Tuetuopay/pimouss-motherboard/3d/KUSBX-SL-CS1N14-B.step

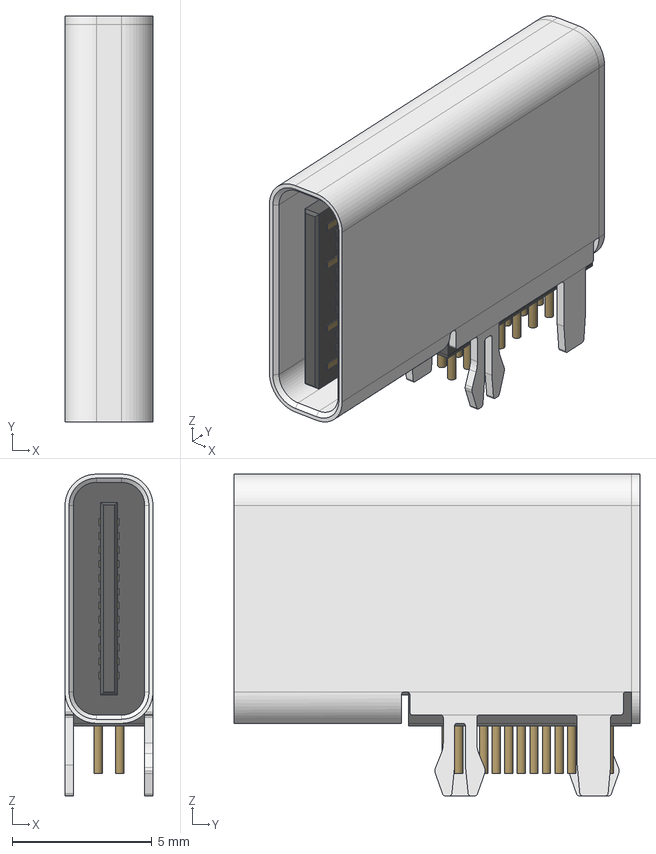
[picture p1: CAD file, 2019-11-23]
3d/KUSBX-SL-CS1N14-B.step
3.15 x 14.6 x 11.5 mm
Plastic
Pins
Contacts
