Tuetuopay/pimouss-motherboard/3d/pcie_4x.step

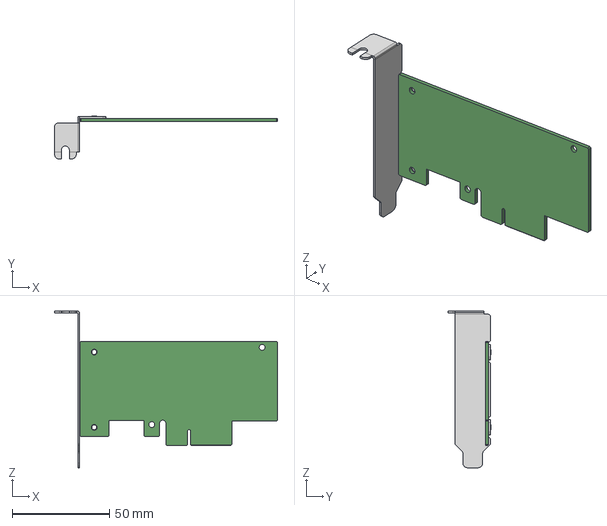
[picture p2: CAD file, 2019-05-04]
3d/pcie_4x.step
114.6 x 22.2 x 80.5 mm
