Tuetuopay/pimouss-motherboard/3d/barrel_jack.step

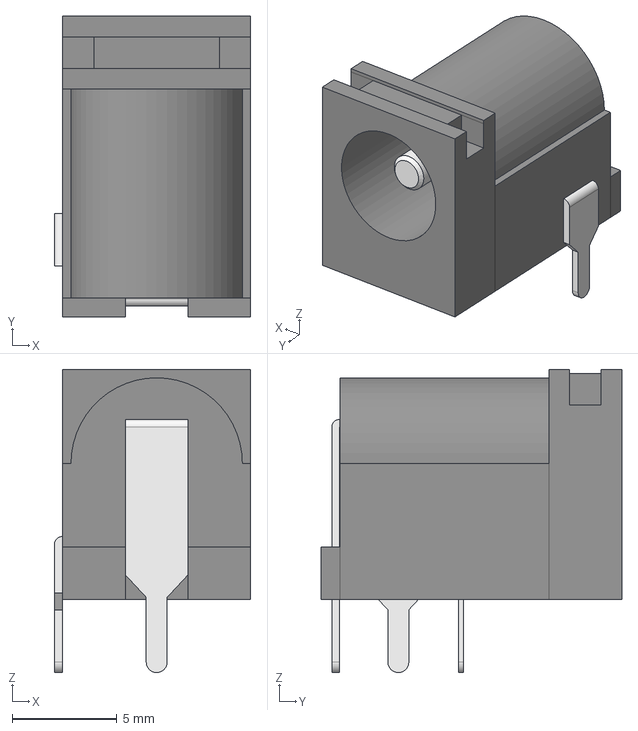
[picture p3: CAD file, 2019-05-04]
3d/barrel_jack.step
9.40 x 14.4 x 14.5 mm
