Tuetuopay/pimouss-motherboard/3d/mpcie_card.step

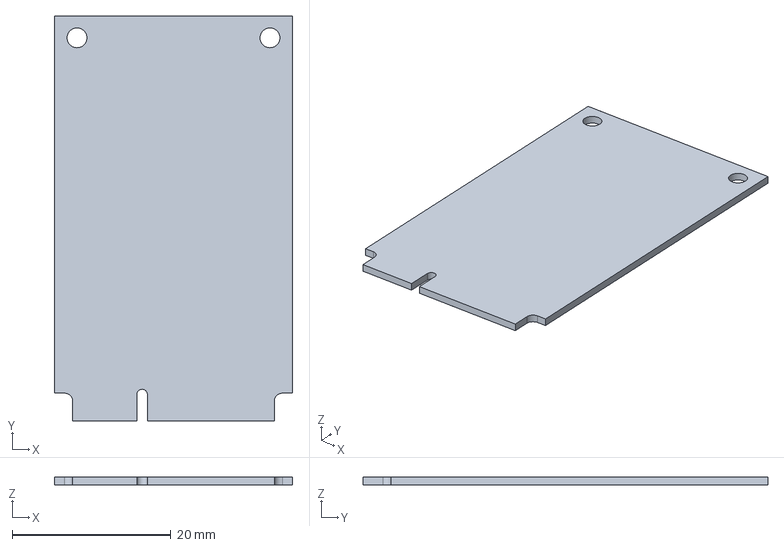
[picture p4: CAD file, 2019-05-04]
3d/mpcie_card.step
30.0 x 51.0 x 1.00 mm
