Tuetuopay/pimouss-motherboard/3d/pimouss.FCStd

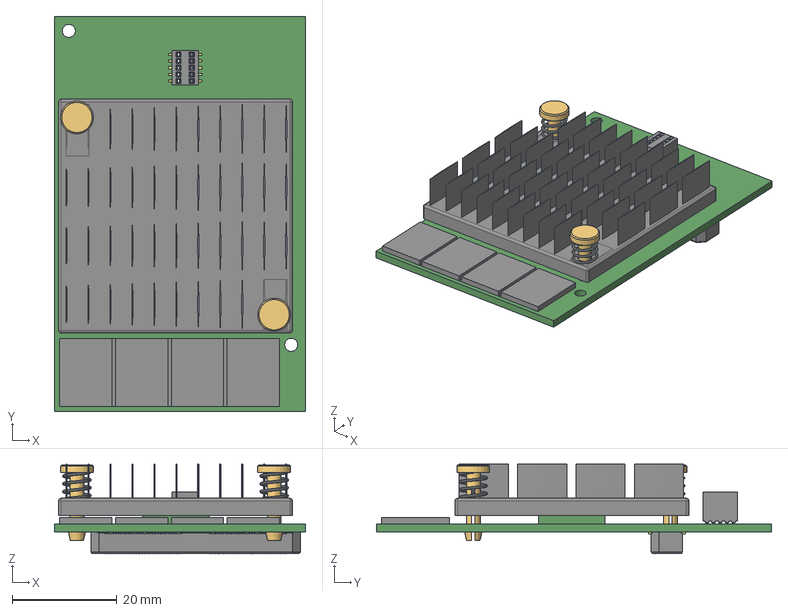
[picture p5: CAD file, 2019-04-30]
3d/pimouss.FCStd
48.0 x 75.5 x 17.1 mm
PCB
radiator
top left prong
bottom right prong
top left prong spring
bottom right prong spring
ram
RSM-105-02-D_socket
RSM-105-02-D_pins
QTH-060-01-F-D_socket
QTH-060-01-F-D_pins_r
QTH-060-01-F-D_pins_l
QTH-060-01-F-D_gnd_r
QTH-060-01-F-D_gnd_l
