Tuetuopay/pimouss-motherboard/3d/L_Vishay_IHHP-0806.step

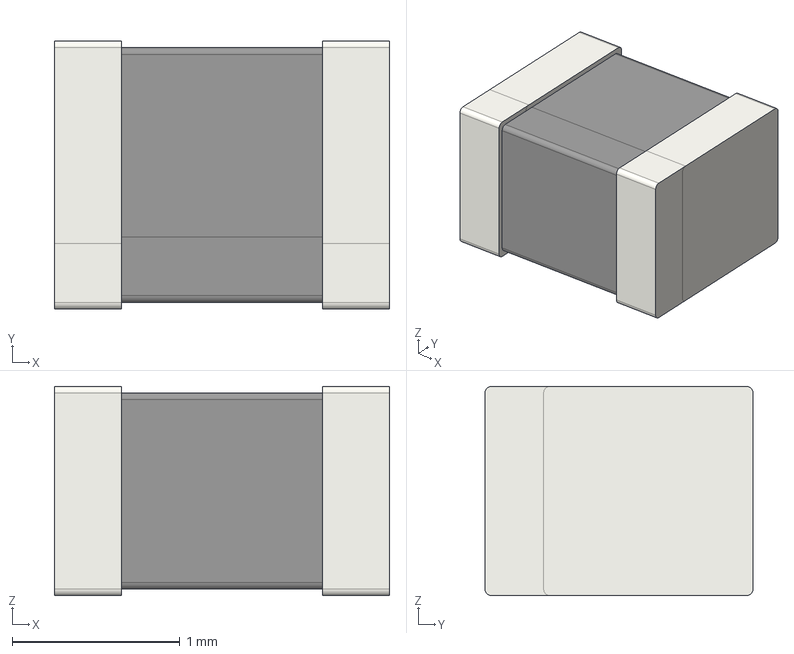
[picture p6: CAD file, 2019-04-01]
3d/L_Vishay_IHHP-0806.step
2.00 x 1.60 x 1.25 mm
