Tuetuopay/pimouss-motherboard/3d/USB-C-FEMALE.stp

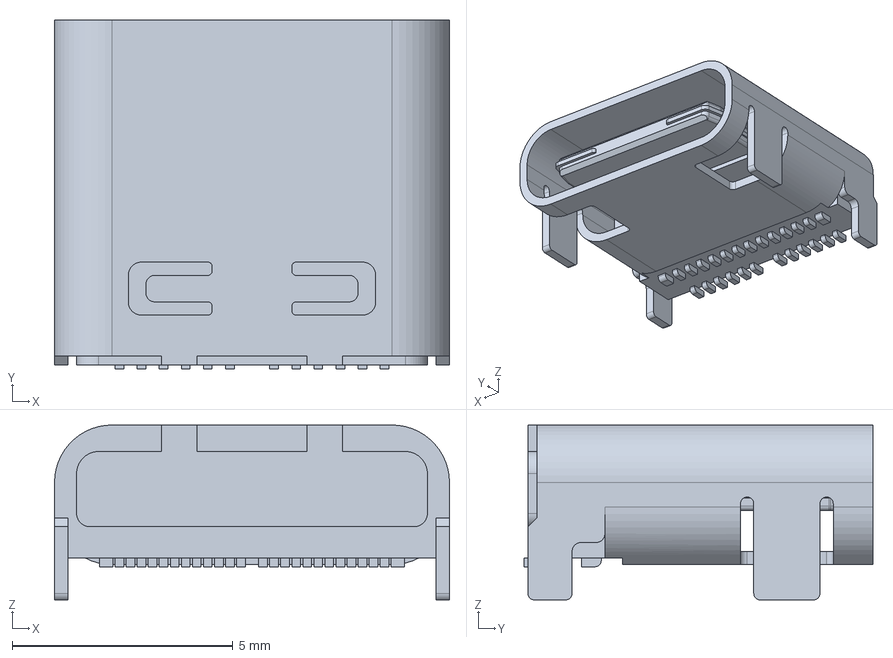
[picture p7: CAD file, 2019-03-24]
3d/USB-C-FEMALE.stp
8.94 x 7.90 x 3.96 mm
