Tuetuopay/pimouss-motherboard/3d/TMS-105-57-G-D.stp

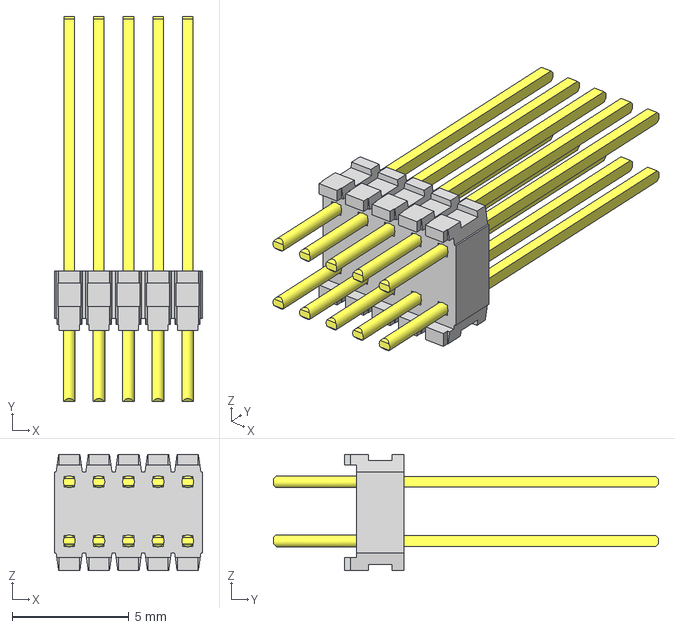
[picture p8: CAD file, 2019-03-24]
3d/TMS-105-57-G-D.stp
6.35 x 16.5 x 4.98 mm
_TMS-105-D_header
_T-1M6-05-57-D
