Tuetuopay/pimouss-motherboard/(list of files, cad)

Other CAD files:
3d/KUSBX-SL-CS1N14-B.FCStd
3d/L_Vishay_IHHP-0806.FCStd
3d/barrel_jack.FCStd
3d/mpcie_card.FCStd
3d/pcie_4x.FCStd
