Tuetuopay/pimouss-motherboard/pimouss-motherboard.kicad_pcb

## KiCad design pimouss-motherboard.kicad_pcb (2019-05-10)

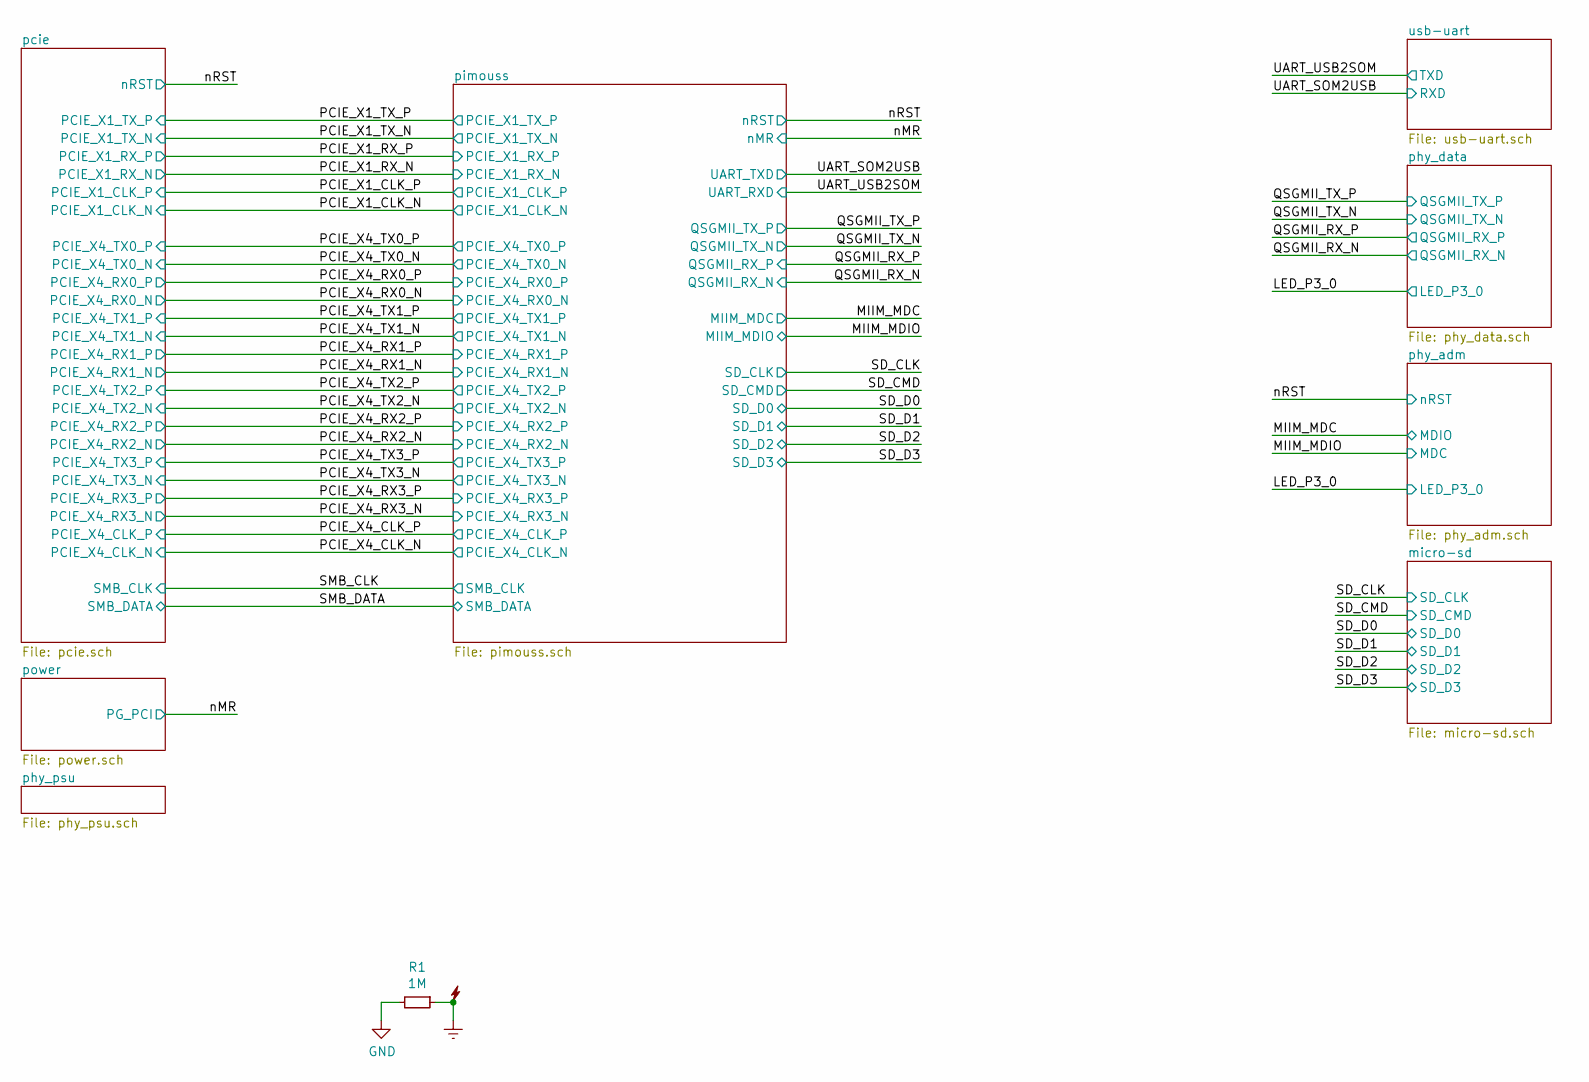
[picture p9: schematic pimouss-motherboard.sch, Pimouss Motherboard]

Parts:
R1: 1M; R_0603_1608Metric

Connections:
Earth: R1.1; also elsewhere on the board

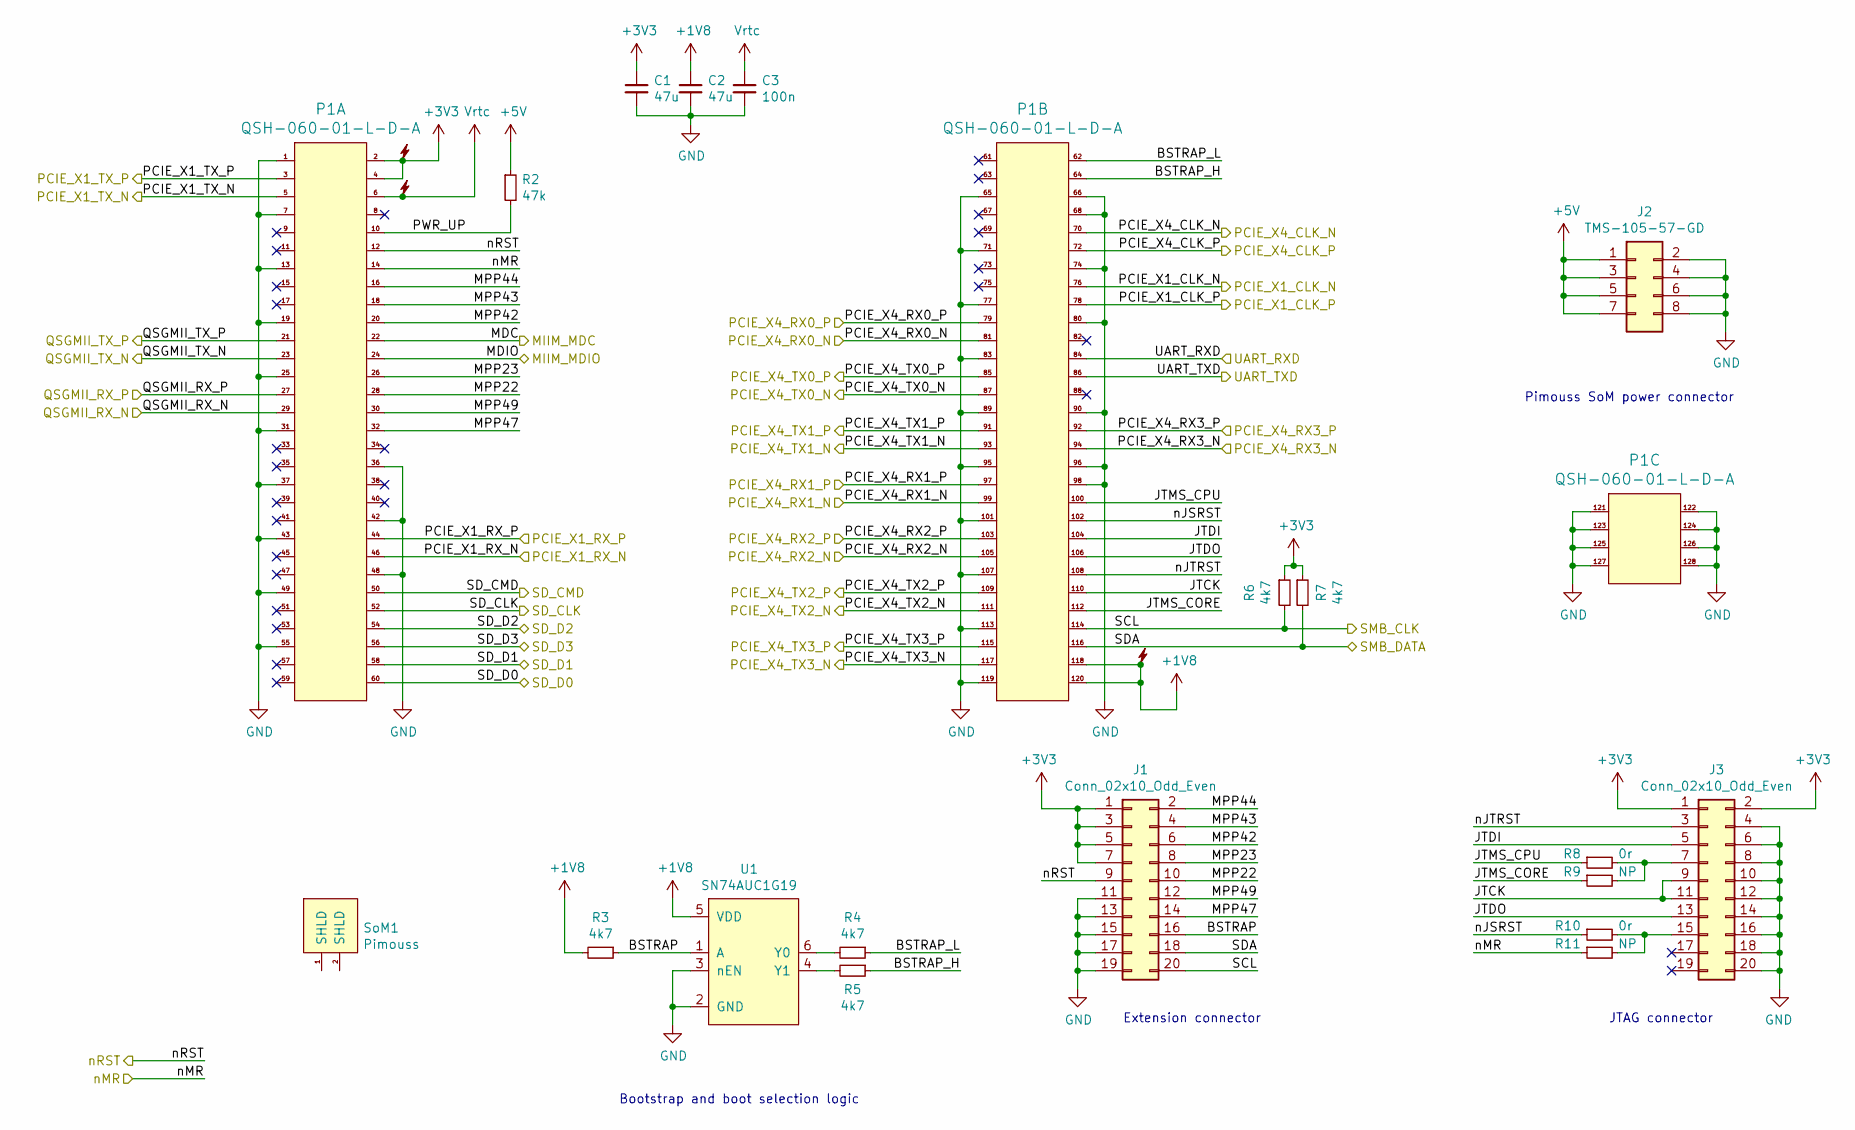
[picture p10: schematic pimouss.sch, The Pimouss itself]

Parts:
C1, C2: 47u; C_0805_2012Metric
C3: 100n; C_0603_1608Metric
J1, J3: Conn_02x10_Odd_Even; PinHeader_2x10_P2.54mm_Vertical
J2: TMS-105-57-GD; TMS-105-57-G-D
P1: QSH-060-01-L-D-A
R2: 47k; R_0603_1608Metric
R3, R4, R5, R6, R7: 4k7; R_0603_1608Metric
R8, R10: 0r; R_0603_1608Metric
R9, R11: NP; R_0603_1608Metric
SoM1: Pimouss
U1: SN74AUC1G19; SOT-23-6

Connections:
/MIIM_MDC: P1.22; also elsewhere on the board
/MIIM_MDIO: P1.24; also elsewhere on the board
/PCIE_X1_CLK_N: P1.76; also elsewhere on the board
/PCIE_X1_CLK_P: P1.78; also elsewhere on the board
/PCIE_X1_RX_N: P1.46; also elsewhere on the board
/PCIE_X1_RX_P: P1.44; also elsewhere on the board
/PCIE_X1_TX_N: P1.5; also elsewhere on the board
/PCIE_X1_TX_P: P1.3; also elsewhere on the board
/PCIE_X4_CLK_N: P1.70; also elsewhere on the board
/PCIE_X4_CLK_P: P1.72; also elsewhere on the board
/PCIE_X4_RX0_N: P1.81; also elsewhere on the board
/PCIE_X4_RX0_P: P1.79; also elsewhere on the board
/PCIE_X4_RX1_N: P1.99; also elsewhere on the board
/PCIE_X4_RX1_P: P1.97; also elsewhere on the board
/PCIE_X4_RX2_N: P1.105; also elsewhere on the board
/PCIE_X4_RX2_P: P1.103; also elsewhere on the board
/PCIE_X4_RX3_N: P1.94; also elsewhere on the board
/PCIE_X4_RX3_P: P1.92; also elsewhere on the board
/PCIE_X4_TX0_N: P1.87; also elsewhere on the board
/PCIE_X4_TX0_P: P1.85; also elsewhere on the board
/PCIE_X4_TX1_N: P1.93; also elsewhere on the board
/PCIE_X4_TX1_P: P1.91; also elsewhere on the board
/PCIE_X4_TX2_N: P1.111; also elsewhere on the board
/PCIE_X4_TX2_P: P1.109; also elsewhere on the board
/PCIE_X4_TX3_N: P1.117; also elsewhere on the board
/PCIE_X4_TX3_P: P1.115; also elsewhere on the board
/QSGMII_RX_N: P1.29; also elsewhere on the board
/QSGMII_RX_P: P1.27; also elsewhere on the board
/QSGMII_TX_N: P1.23; also elsewhere on the board
/QSGMII_TX_P: P1.21; also elsewhere on the board
/SD_CLK: P1.52; also elsewhere on the board
/SD_CMD: P1.50; also elsewhere on the board
/SD_D0: P1.60; also elsewhere on the board
/SD_D1: P1.58; also elsewhere on the board
/SD_D2: P1.54; also elsewhere on the board
/SD_D3: P1.56; also elsewhere on the board
/SMB_CLK: J1.20, P1.114, R6.2; also elsewhere on the board
/SMB_DATA: J1.18, P1.116, R7.2; also elsewhere on the board
/UART_SOM2USB: P1.86; also elsewhere on the board
/UART_USB2SOM: P1.84; also elsewhere on the board
/nMR: P1.14, R11.1; also elsewhere on the board
/nRST: J1.9, P1.12; also elsewhere on the board
/pimouss/BSTRAP: J1.16, R3.1, U1.1 (A)
/pimouss/BSTRAP_H: P1.64, R5.1
/pimouss/BSTRAP_L: P1.62, R4.1
/pimouss/JTCK: J3.9, J3.11, P1.110
/pimouss/JTDI: J3.5, P1.104
/pimouss/JTDO: J3.13, P1.106
/pimouss/JTMS_CORE: P1.112, R9.1
/pimouss/JTMS_CPU: P1.100, R8.1
/pimouss/MPP22: J1.10, P1.28
/pimouss/MPP23: J1.8, P1.26
/pimouss/MPP42: J1.6, P1.20
/pimouss/MPP43: J1.4, P1.18
/pimouss/MPP44: J1.2, P1.16
/pimouss/MPP47: J1.14, P1.32
/pimouss/MPP49: J1.12, P1.30
/pimouss/PWR_UP: P1.10, R2.2
/pimouss/nJSRST: P1.102, R10.1
/pimouss/nJTRST: J3.3, P1.108
unnamed: J3.7, R8.2, R9.2
unnamed: J3.15, R10.2, R11.2
unnamed: R4.2, U1.6 (Y0)
unnamed: R5.2, U1.4 (Y1)

Notes on the sheet:
Pimouss SoM power connector
Bootstrap and boot selection logic
JTAG connector
Extension connector

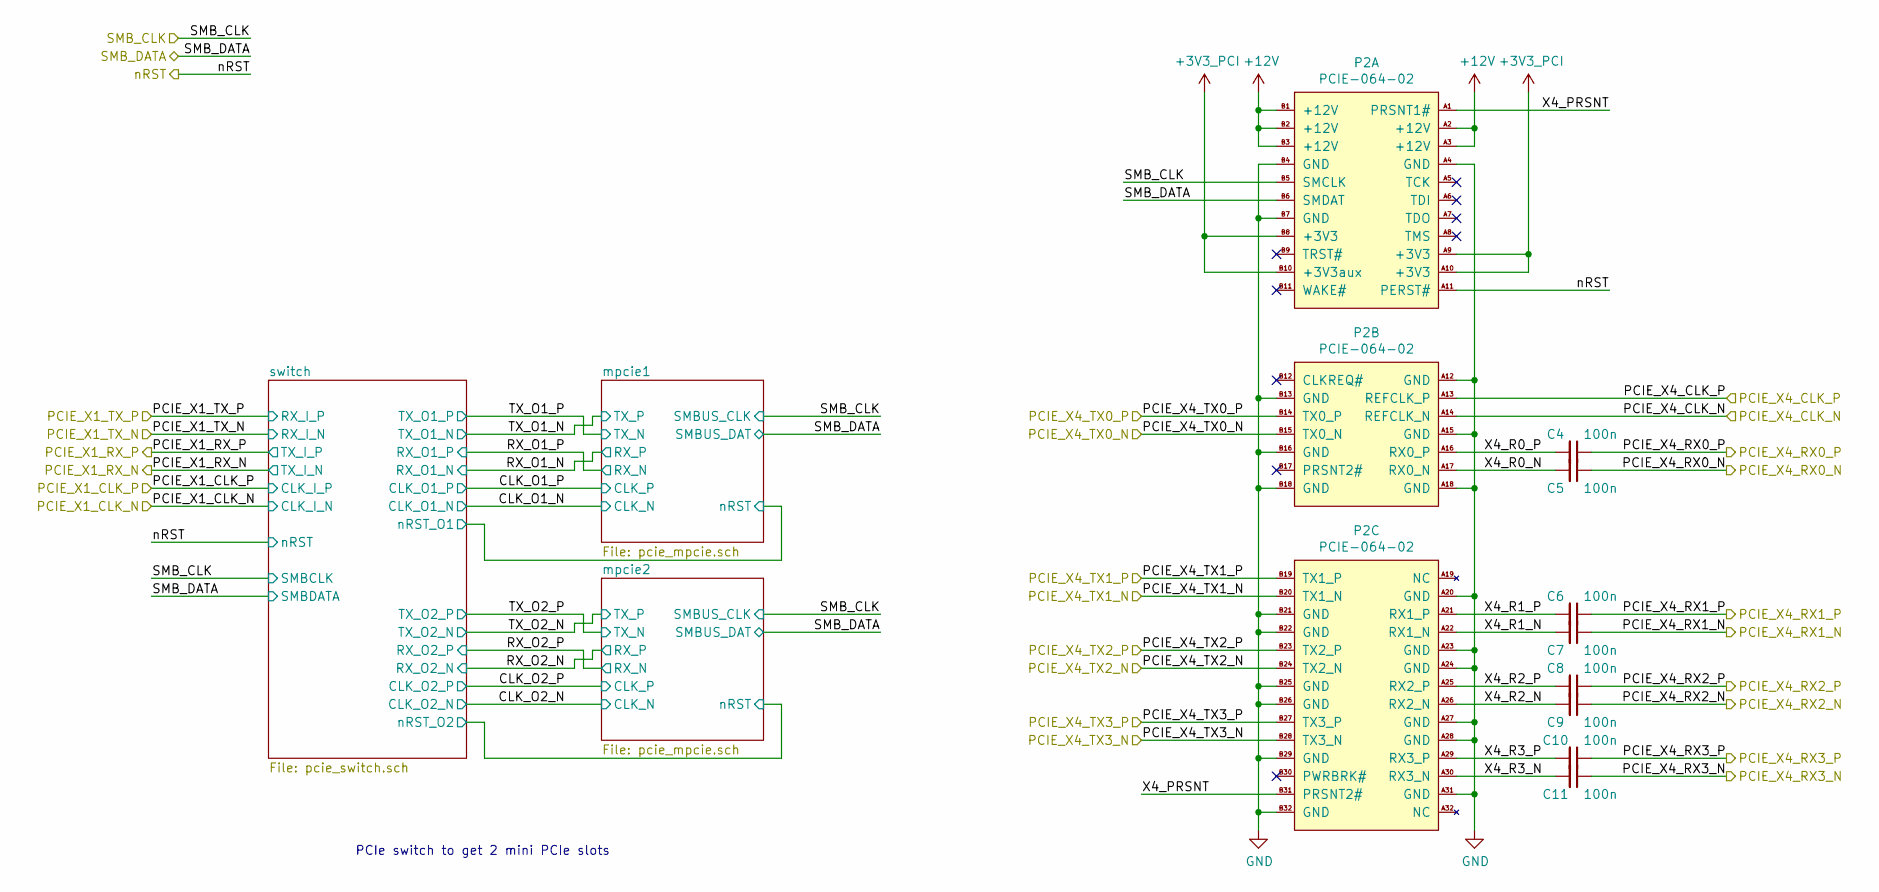
[picture p11: schematic pcie.sch, PCI Express connectors]

Parts:
C4, C5, C6, C7, C8, C9, C10, C11: 100n; C_0402_1005Metric
P2: PCIE-064-02; SAMTEC_PCIE-064-02-F-D-TH

Connections:
/PCIE_X4_CLK_N: P2.A14 (REFCLK_N); also elsewhere on the board
/PCIE_X4_CLK_P: P2.A13 (REFCLK_P); also elsewhere on the board
/PCIE_X4_RX0_N: C5.1; also elsewhere on the board
/PCIE_X4_RX0_P: C4.1; also elsewhere on the board
/PCIE_X4_RX1_N: C7.1; also elsewhere on the board
/PCIE_X4_RX1_P: C6.1; also elsewhere on the board
/PCIE_X4_RX2_N: C9.1; also elsewhere on the board
/PCIE_X4_RX2_P: C8.1; also elsewhere on the board
/PCIE_X4_RX3_N: C11.1; also elsewhere on the board
/PCIE_X4_RX3_P: C10.1; also elsewhere on the board
/PCIE_X4_TX0_N: P2.B15 (TX0_N); also elsewhere on the board
/PCIE_X4_TX0_P: P2.B14 (TX0_P); also elsewhere on the board
/PCIE_X4_TX1_N: P2.B20 (TX1_N); also elsewhere on the board
/PCIE_X4_TX1_P: P2.B19 (TX1_P); also elsewhere on the board
/PCIE_X4_TX2_N: P2.B24 (TX2_N); also elsewhere on the board
/PCIE_X4_TX2_P: P2.B23 (TX2_P); also elsewhere on the board
/PCIE_X4_TX3_N: P2.B28 (TX3_N); also elsewhere on the board
/PCIE_X4_TX3_P: P2.B27 (TX3_P); also elsewhere on the board
/SMB_CLK: P2.B5 (SMCLK); also elsewhere on the board
/SMB_DATA: P2.B6 (SMDAT); also elsewhere on the board
/nRST: P2.A11 (PERST#); also elsewhere on the board
/pcie/X4_PRSNT: P2.A1 (PRSNT1#), P2.B31 (PRSNT2#)
/pcie/X4_R0_N: C5.2, P2.A17 (RX0_N)
/pcie/X4_R0_P: C4.2, P2.A16 (RX0_P)
/pcie/X4_R1_N: C7.2, P2.A22 (RX1_N)
/pcie/X4_R1_P: C6.2, P2.A21 (RX1_P)
/pcie/X4_R2_N: C9.2, P2.A26 (RX2_N)
/pcie/X4_R2_P: C8.2, P2.A25 (RX2_P)
/pcie/X4_R3_N: C11.2, P2.A30 (RX3_N)
/pcie/X4_R3_P: C10.2, P2.A29 (RX3_P)

Notes on the sheet:
PCIe switch to get 2 mini PCIe slots

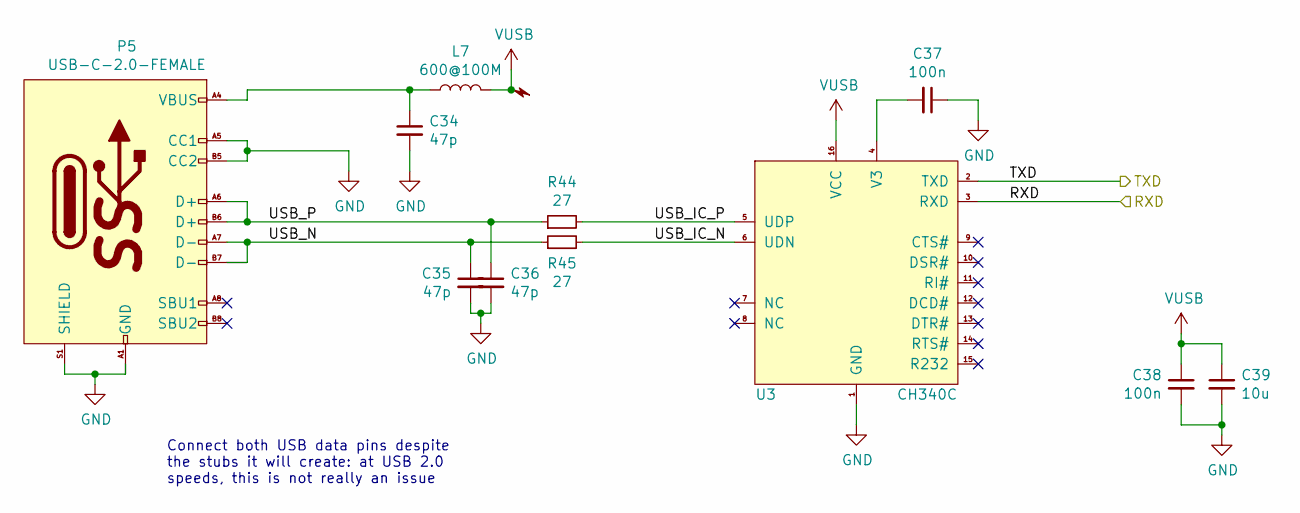
[picture p12: schematic usb-uart.sch, USB to UART conversion]

Parts:
C34, C35, C36: 47p; C_0603_1608Metric
C37, C38: 100n; C_0603_1608Metric
C39: 10u; C_0603_1608Metric
L7: 600@100M; L_0603_1608Metric
P5: USB-C-2.0-FEMALE; USB-C-FEMALE
R44, R45: 27; R_0603_1608Metric
U3: CH340C; SSOP-20_5.3x7.2mm_P0.65mm

Connections:
/UART_SOM2USB: U3.3 (RXD); also elsewhere on the board
/UART_USB2SOM: U3.2 (TXD); also elsewhere on the board
/usb-uart/USB_IC_N: R45.2, U3.6 (UDN)
/usb-uart/USB_IC_P: R44.2, U3.5 (UDP)
/usb-uart/USB_N: C35.1, P5.A7 (D-), P5.B7 (D-), R45.1
/usb-uart/USB_P: C36.1, P5.A6 (D+), P5.B6 (D+), R44.1
unnamed: C34.1, L7.1, P5.A4 (VBUS), P5.A9 (VBUS), P5.B4 (VBUS), P5.B9 (VBUS)
unnamed: C37.2, U3.4 (V3)
VUSB: C38.1, C39.1, L7.2, U3.16 (VCC)

Notes on the sheet:
Connect both USB data pins despite the stubs it will create: at USB 2.0 speeds, this is not really an issue

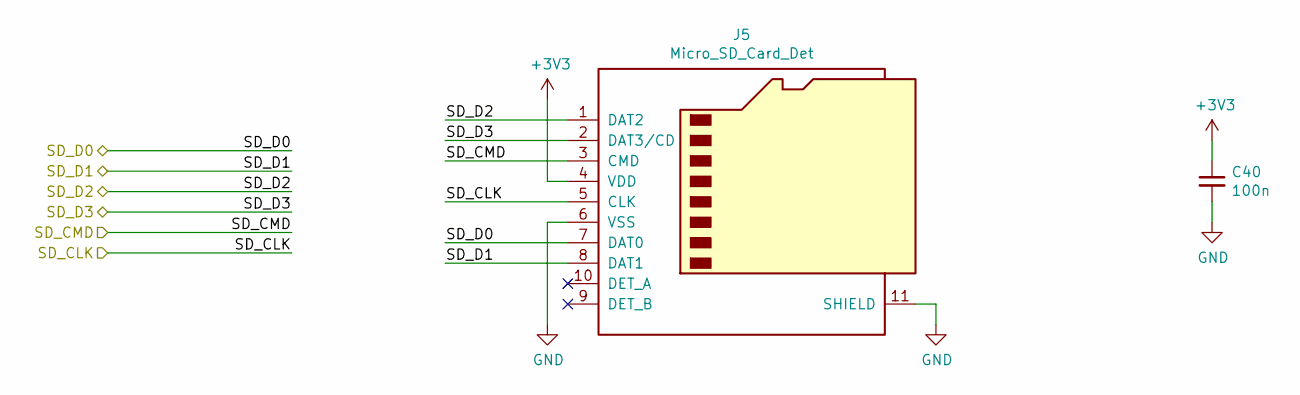
[picture p13: schematic micro-sd.sch, µSD Card storage]

Parts:
C40: 100n; C_0603_1608Metric
J5: Micro_SD_Card_Det; microSD_HC_Hirose_DM3D-SF

Connections:
/SD_CLK: J5.5 (CLK); also elsewhere on the board
/SD_CMD: J5.3 (CMD); also elsewhere on the board
/SD_D0: J5.7 (DAT0); also elsewhere on the board
/SD_D1: J5.8 (DAT1); also elsewhere on the board
/SD_D2: J5.1 (DAT2); also elsewhere on the board
/SD_D3: J5.2 (DAT3/CD); also elsewhere on the board

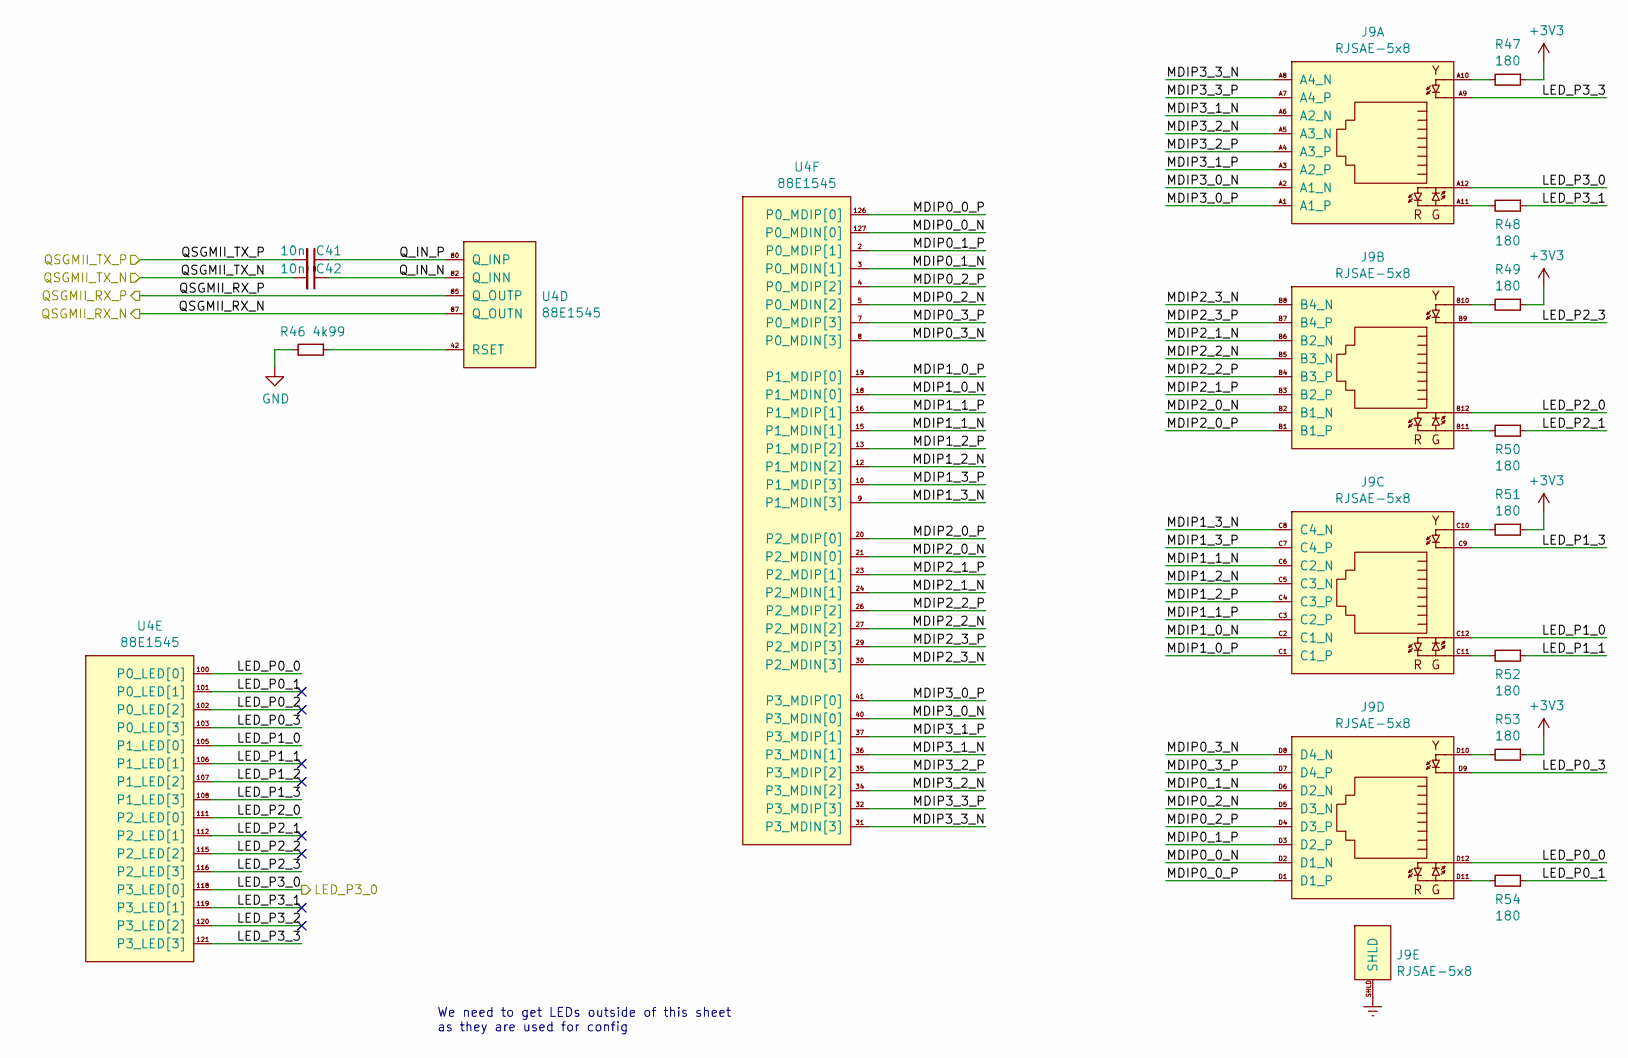
[picture p14: schematic phy_data.sch, PHY data plane]

Parts:
C41, C42: 10n; C_0402_1005Metric
J9: RJSAE-5x8
R46: 4k99; R_0603_1608Metric
R47, R48, R49, R50, R51, R52, R53, R54: 180; R_0603_1608Metric
U4: 88E1545; LQFP-128-1EP_14x20mm_P0.5mm_EP3.93x6.42mm

Connections:
/LED_P3_0: J9.A12, U4.118 (P3_LED[0]); also elsewhere on the board
/QSGMII_RX_N: U4.87 (Q_OUTN); also elsewhere on the board
/QSGMII_RX_P: U4.85 (Q_OUTP); also elsewhere on the board
/QSGMII_TX_N: C42.2; also elsewhere on the board
/QSGMII_TX_P: C41.2; also elsewhere on the board
/phy_data/LED_P0_0: J9.D12, U4.100 (P0_LED[0])
/phy_data/LED_P0_1: R54.1, U4.101 (P0_LED[1])
/phy_data/LED_P0_2: U4.102 (P0_LED[2])
/phy_data/LED_P0_3: J9.D9, U4.103 (P0_LED[3])
/phy_data/LED_P1_0: J9.C12, U4.105 (P1_LED[0])
/phy_data/LED_P1_1: R52.1, U4.106 (P1_LED[1])
/phy_data/LED_P1_2: U4.107 (P1_LED[2])
/phy_data/LED_P1_3: J9.C9, U4.108 (P1_LED[3])
/phy_data/LED_P2_0: J9.B12, U4.111 (P2_LED[0])
/phy_data/LED_P2_1: R50.1, U4.112 (P2_LED[1])
/phy_data/LED_P2_2: U4.115 (P2_LED[2])
/phy_data/LED_P2_3: J9.B9, U4.116 (P2_LED[3])
/phy_data/LED_P3_1: R48.1, U4.119 (P3_LED[1])
/phy_data/LED_P3_2: U4.120 (P3_LED[2])
/phy_data/LED_P3_3: J9.A9, U4.121 (P3_LED[3])
/phy_data/MDIP0_0_N: J9.D2 (D1_N), U4.127 (P0_MDIN[0])
/phy_data/MDIP0_0_P: J9.D1 (D1_P), U4.126 (P0_MDIP[0])
/phy_data/MDIP0_1_N: J9.D6 (D2_N), U4.3 (P0_MDIN[1])
/phy_data/MDIP0_1_P: J9.D3 (D2_P), U4.2 (P0_MDIP[1])
/phy_data/MDIP0_2_N: J9.D5 (D3_N), U4.5 (P0_MDIN[2])
/phy_data/MDIP0_2_P: J9.D4 (D3_P), U4.4 (P0_MDIP[2])
/phy_data/MDIP0_3_N: J9.D8 (D4_N), U4.8 (P0_MDIN[3])
/phy_data/MDIP0_3_P: J9.D7 (D4_P), U4.7 (P0_MDIP[3])
/phy_data/MDIP1_0_N: J9.C2 (C1_N), U4.18 (P1_MDIN[0])
/phy_data/MDIP1_0_P: J9.C1 (C1_P), U4.19 (P1_MDIP[0])
/phy_data/MDIP1_1_N: J9.C6 (C2_N), U4.15 (P1_MDIN[1])
/phy_data/MDIP1_1_P: J9.C3 (C2_P), U4.16 (P1_MDIP[1])
/phy_data/MDIP1_2_N: J9.C5 (C3_N), U4.12 (P1_MDIN[2])
/phy_data/MDIP1_2_P: J9.C4 (C3_P), U4.13 (P1_MDIP[2])
/phy_data/MDIP1_3_N: J9.C8 (C4_N), U4.9 (P1_MDIN[3])
/phy_data/MDIP1_3_P: J9.C7 (C4_P), U4.10 (P1_MDIP[3])
/phy_data/MDIP2_0_N: J9.B2 (B1_N), U4.21 (P2_MDIN[0])
/phy_data/MDIP2_0_P: J9.B1 (B1_P), U4.20 (P2_MDIP[0])
/phy_data/MDIP2_1_N: J9.B6 (B2_N), U4.24 (P2_MDIN[1])
/phy_data/MDIP2_1_P: J9.B3 (B2_P), U4.23 (P2_MDIP[1])
/phy_data/MDIP2_2_N: J9.B5 (B3_N), U4.27 (P2_MDIN[2])
/phy_data/MDIP2_2_P: J9.B4 (B3_P), U4.26 (P2_MDIP[2])
/phy_data/MDIP2_3_N: J9.B8 (B4_N), U4.30 (P2_MDIN[3])
/phy_data/MDIP2_3_P: J9.B7 (B4_P), U4.29 (P2_MDIP[3])
/phy_data/MDIP3_0_N: J9.A2 (A1_N), U4.40 (P3_MDIN[0])
/phy_data/MDIP3_0_P: J9.A1 (A1_P), U4.41 (P3_MDIP[0])
/phy_data/MDIP3_1_N: J9.A6 (A2_N), U4.36 (P3_MDIN[1])
/phy_data/MDIP3_1_P: J9.A3 (A2_P), U4.37 (P3_MDIP[1])
/phy_data/MDIP3_2_N: J9.A5 (A3_N), U4.34 (P3_MDIN[2])
/phy_data/MDIP3_2_P: J9.A4 (A3_P), U4.35 (P3_MDIP[2])
/phy_data/MDIP3_3_N: J9.A8 (A4_N), U4.31 (P3_MDIN[3])
/phy_data/MDIP3_3_P: J9.A7 (A4_P), U4.32 (P3_MDIP[3])
/phy_data/Q_IN_N: C42.1, U4.82 (Q_INN)
/phy_data/Q_IN_P: C41.1, U4.80 (Q_INP)
Earth: J9.SHLD; also elsewhere on the board
unnamed: J9.A10, R47.2
unnamed: J9.A11, R48.2
unnamed: J9.B10, R49.2
unnamed: J9.B11, R50.2
unnamed: J9.C10, R51.2
unnamed: J9.C11, R52.2
unnamed: J9.D10, R53.2
unnamed: J9.D11, R54.2
unnamed: R46.1, U4.42 (RSET)

Notes on the sheet:
We need to get LEDs outside of this sheet as they are used for config

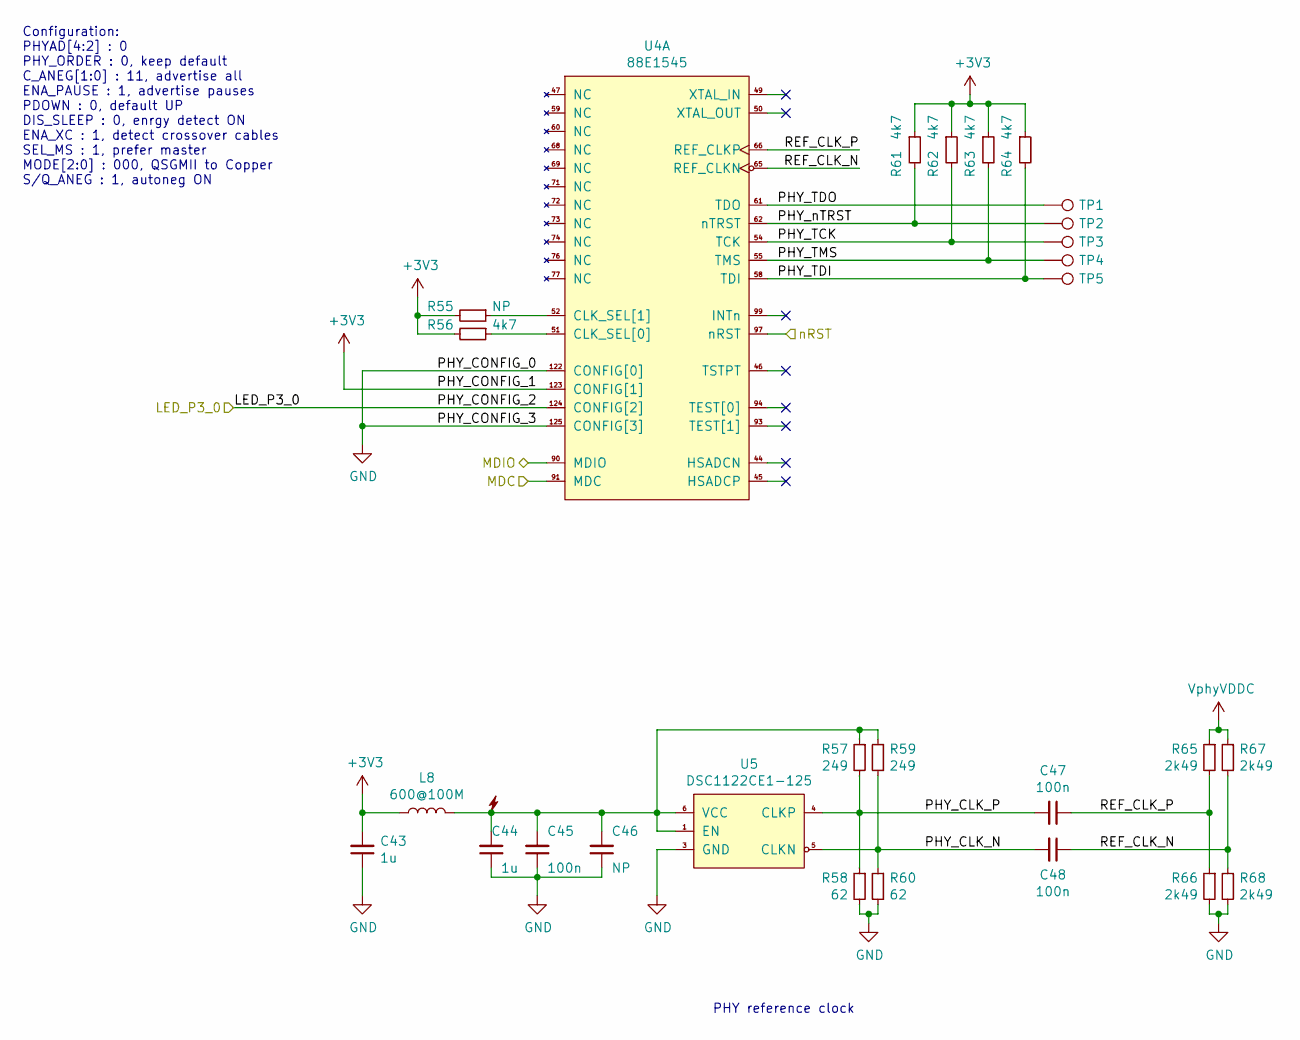
[picture p15: schematic phy_adm.sch, PHY control plane]

Parts:
C43, C44: 1u; C_0603_1608Metric
C45: 100n; C_0603_1608Metric
C46: NP; C_0603_1608Metric
C47, C48: 100n; C_0402_1005Metric
L8: 600@100M; L_0603_1608Metric
R55: NP; R_0603_1608Metric
R56, R61, R62, R63, R64: 4k7; R_0603_1608Metric
R57, R59: 249; R_0402_1005Metric
R58, R60: 62; R_0402_1005Metric
R65, R66, R67, R68: 2k49; R_0402_1005Metric
TP1, TP2, TP3, TP4, TP5: TestPoint; TestPoint_Pad_D1.0mm
U4: 88E1545; LQFP-128-1EP_14x20mm_P0.5mm_EP3.93x6.42mm
U5: DSC1122CE1-125; DFN-6_2.5x2mm_P0.825mm

Connections:
/LED_P3_0: U4.124 (CONFIG[2]); also elsewhere on the board
/MIIM_MDC: U4.90 (MDIO); also elsewhere on the board
/MIIM_MDIO: U4.91 (MDC); also elsewhere on the board
/nRST: U4.97 (nRST); also elsewhere on the board
/phy_adm/PHY_CLK_N: C48.2, R59.2, R60.1, U5.5 (CLKN)
/phy_adm/PHY_CLK_P: C47.2, R57.2, R58.1, U5.4 (CLKP)
/phy_adm/PHY_TCK: R62.2, TP3.1, U4.54 (TCK)
/phy_adm/PHY_TDI: R64.2, TP5.1, U4.58 (TDI)
/phy_adm/PHY_TDO: TP1.1, U4.61 (TDO)
/phy_adm/PHY_TMS: R63.2, TP4.1, U4.55 (TMS)
/phy_adm/PHY_nTRST: R61.2, TP2.1, U4.62 (nTRST)
/phy_adm/REF_CLK_N: C48.1, R67.2, R68.1, U4.65 (REF_CLKN)
/phy_adm/REF_CLK_P: C47.1, R65.2, R66.1, U4.66 (REF_CLKP)
unnamed: C44.2, C45.2, C46.2, L8.2, R57.1, R59.1, U5.1 (EN), U5.6 (VCC)
unnamed: R55.1, U4.52 (CLK_SEL[1])
unnamed: R56.1, U4.51 (CLK_SEL[0])

Notes on the sheet:
Configuration: PHYAD[4:2] : 0 PHY_ORDER : 0, keep default C_ANEG[1:0] : 11, advertise all ENA_PAUSE : 1, advertise pauses PDOWN : 0, default UP DIS_SLEEP : 0, enrgy detect ON ENA_XC : 1, detect crossover cables SEL_MS : 1, prefer master MODE[2:0] : 000, QSGMII to Copper S/Q_ANEG : 1, autoneg ON
PHY reference clock

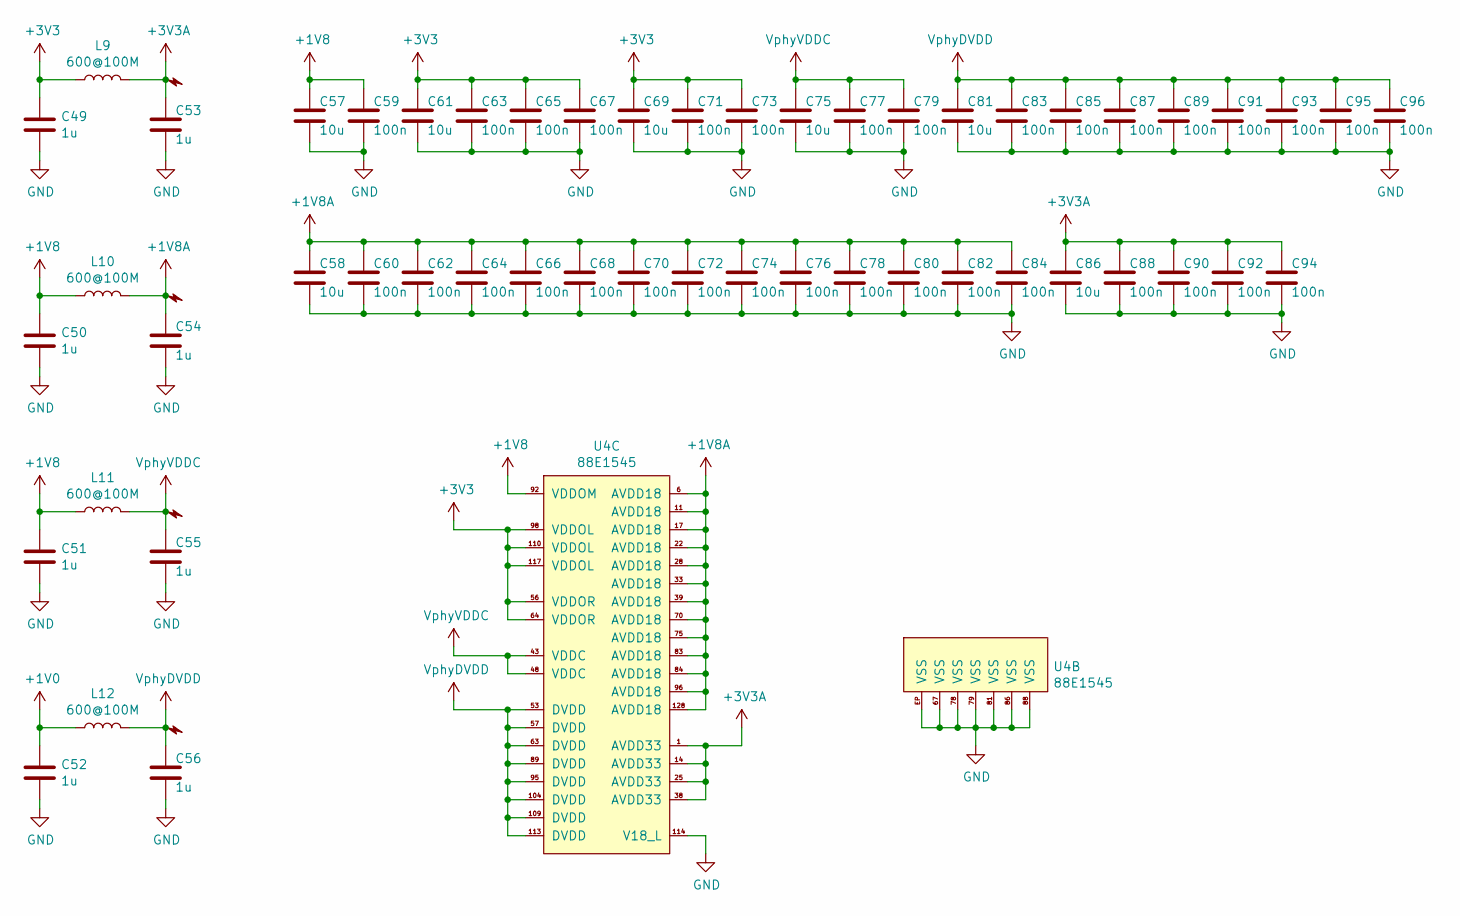
[picture p16: schematic phy_psu.sch, PHY power supply]

Parts:
C49, C50, C51, C52, C53, C54, C55, C56: 1u; C_0603_1608Metric
C57, C58, C61, C69, C75, C81, C86: 10u; C_0603_1608Metric
C59, C60, C62, C63, C64, C65, C66, C67, C68, C70, C71, C72, C73, C74, C76, C77, C78, C79, C80, C82, C83, C84, C85, C87, C88, C89, C90, C91, C92, C93, C94, C95, C96: 100n; C_0603_1608Metric
L9, L10, L11, L12: 600@100M; L_0603_1608Metric
U4: 88E1545; LQFP-128-1EP_14x20mm_P0.5mm_EP3.93x6.42mm

Connections:
+1V0: C52.1, L12.1; also elsewhere on the board

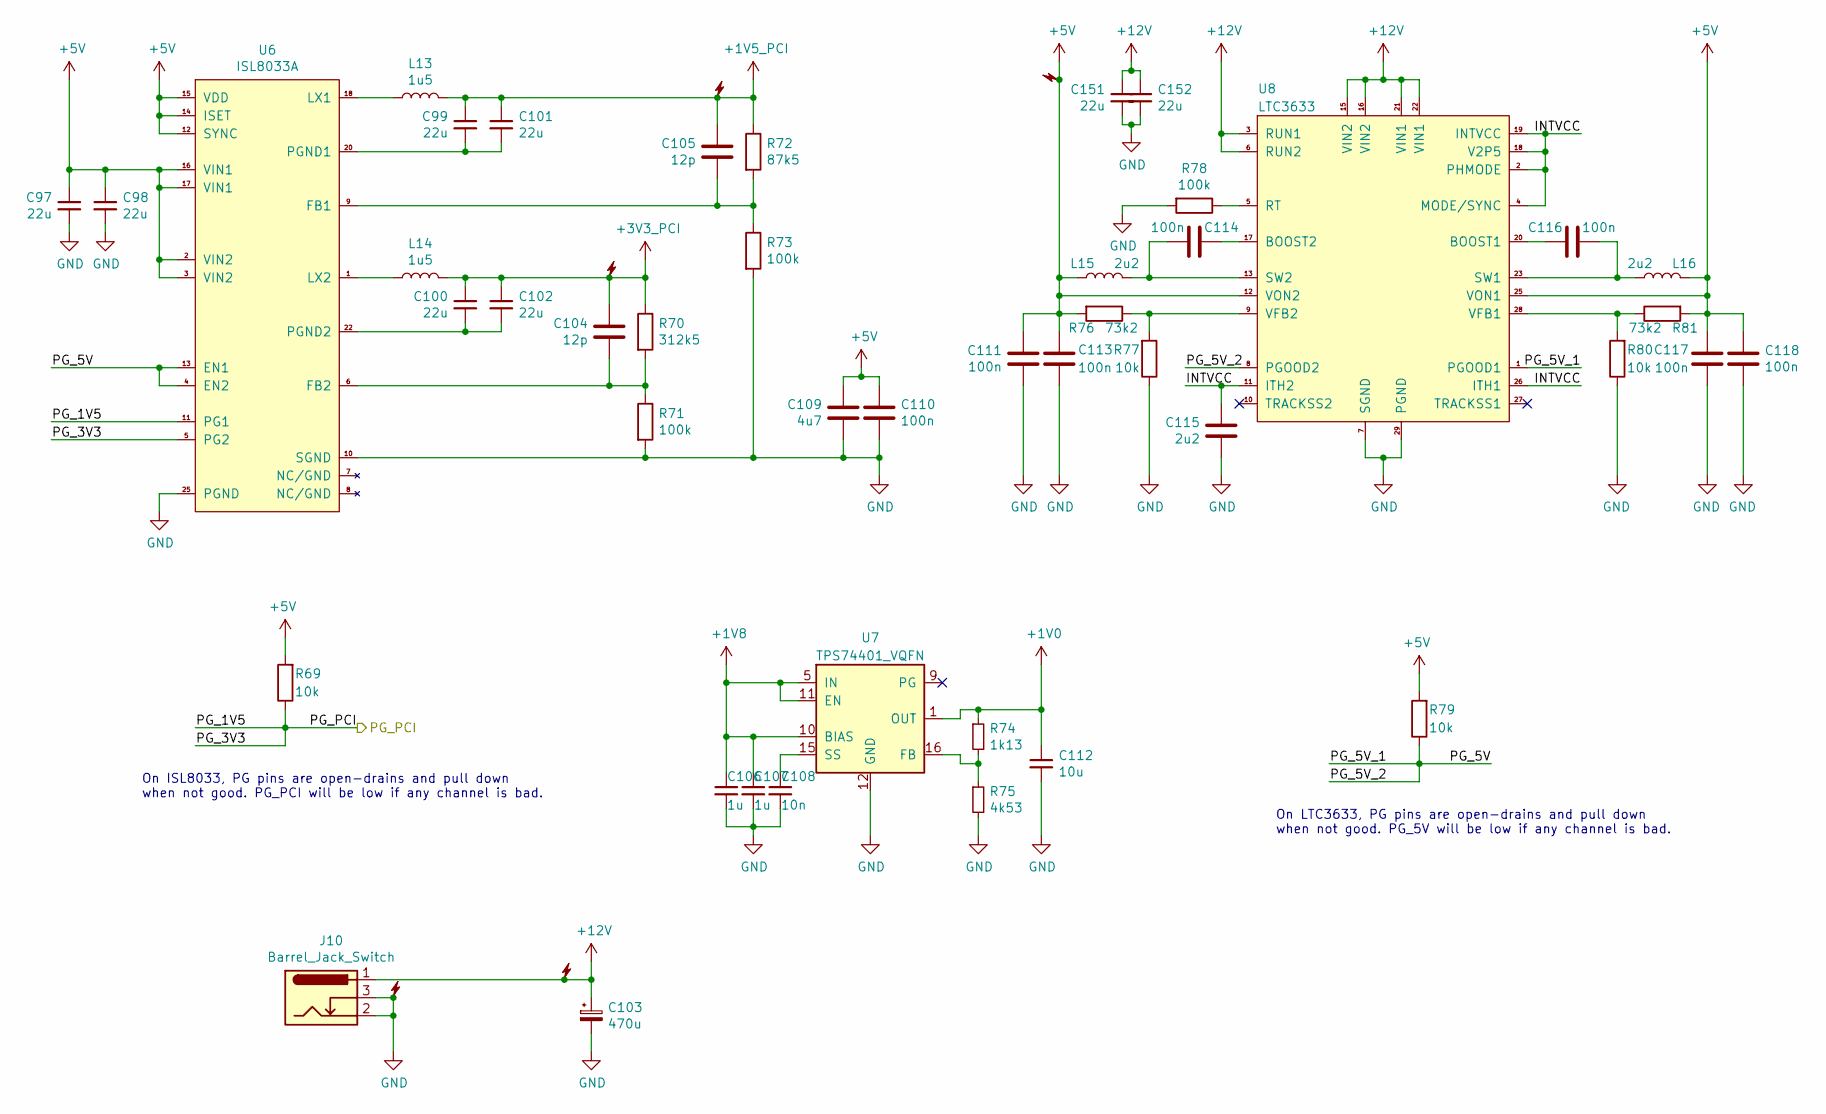
[picture p17: schematic power.sch, Main board power supplies]

Parts:
C97, C98, C99, C100, C101, C102, C151, C152: 22u; C_0805_2012Metric
C103: 470u; CP_Elec_10x10
C104, C105: 12p; C_0603_1608Metric
C106, C107: 1u; C_0603_1608Metric
C108: 10n; C_0603_1608Metric
C109: 4u7; C_0603_1608Metric
C110, C111, C113, C114, C116, C117, C118: 100n; C_0603_1608Metric
C112: 10u; C_0603_1608Metric
C115: 2u2; C_0603_1608Metric
J10: Barrel_Jack_Switch; BarrelJack_Horizontal
L13, L14: 1u5; L_Vishay_IHHP-0806
L15, L16: 2u2; L_Vishay_IHHP-0806
R69, R77, R79, R80: 10k; R_0603_1608Metric
R70: 312k5; R_0603_1608Metric
R71, R73, R78: 100k; R_0603_1608Metric
R72: 87k5; R_0603_1608Metric
R74: 1k13; R_0603_1608Metric
R75: 4k53; R_0603_1608Metric
R76, R81: 73k2; R_0603_1608Metric
U6: ISL8033A; QFN-24-1EP_4x4mm_P0.5mm_EP2.6x2.6mm
U7: TPS74401_VQFN; Texas_S-PVQFN-N20_EP3.15x3.15mm_ThermalVias
U8: LTC3633; QFN-28-1EP_4x5mm_P0.5mm_EP2.65x3.65mm_ThermalVias

Connections:
+1V0: C112.1, R74.1, U7.1 (OUT), U7.18 (OUT), U7.19 (OUT), U7.20 (OUT); also elsewhere on the board
/nMR: R69.1, U6.5 (PG2), U6.11 (PG1); also elsewhere on the board
/power/INTVCC: C115.2, U8.2 (PHMODE), U8.4 (MODE/SYNC), U8.11 (ITH2), U8.18 (V2P5), U8.19 (INTVCC), U8.26 (ITH1)
/power/PG_5V: R79.1, U6.4 (EN2), U6.13 (EN1), U8.1 (PGOOD1), U8.8 (PGOOD2)
unnamed: C100.2, C102.2, U6.22 (PGND2), U6.23 (PGND2)
unnamed: C99.2, C101.2, U6.20 (PGND1), U6.21 (PGND1)
unnamed: C104.2, R70.2, R71.1, U6.6 (FB2)
unnamed: C105.2, R72.2, R73.1, U6.9 (FB1)
unnamed: C108.1, U7.15 (SS)
unnamed: C114.1, U8.17 (BOOST2)
unnamed: C114.2, L15.2, U8.13 (SW2), U8.14 (SW2)
unnamed: C116.1, U8.20 (BOOST1)
unnamed: C116.2, L16.2, U8.23 (SW1), U8.24 (SW1)
unnamed: L13.1, U6.18 (LX1), U6.19 (LX1)
unnamed: L14.1, U6.1 (LX2), U6.24 (LX2)
unnamed: R74.2, R75.1, U7.16 (FB)
unnamed: R76.1, R77.2, U8.9 (VFB2)
unnamed: R78.1, U8.5 (RT)
unnamed: R80.2, R81.1, U8.28 (VFB1)

Notes on the sheet:
On LTC3633, PG pins are open-drains and pull down when not good. PG_5V will be low if any channel is bad.
On ISL8033, PG pins are open-drains and pull down when not good. PG_PCI will be low if any channel is bad.
