Tuetuopay/pimouss-motherboard/pimouss-motherboard.kicad_pcb

## KiCad design pimouss-motherboard.kicad_pcb (continued)

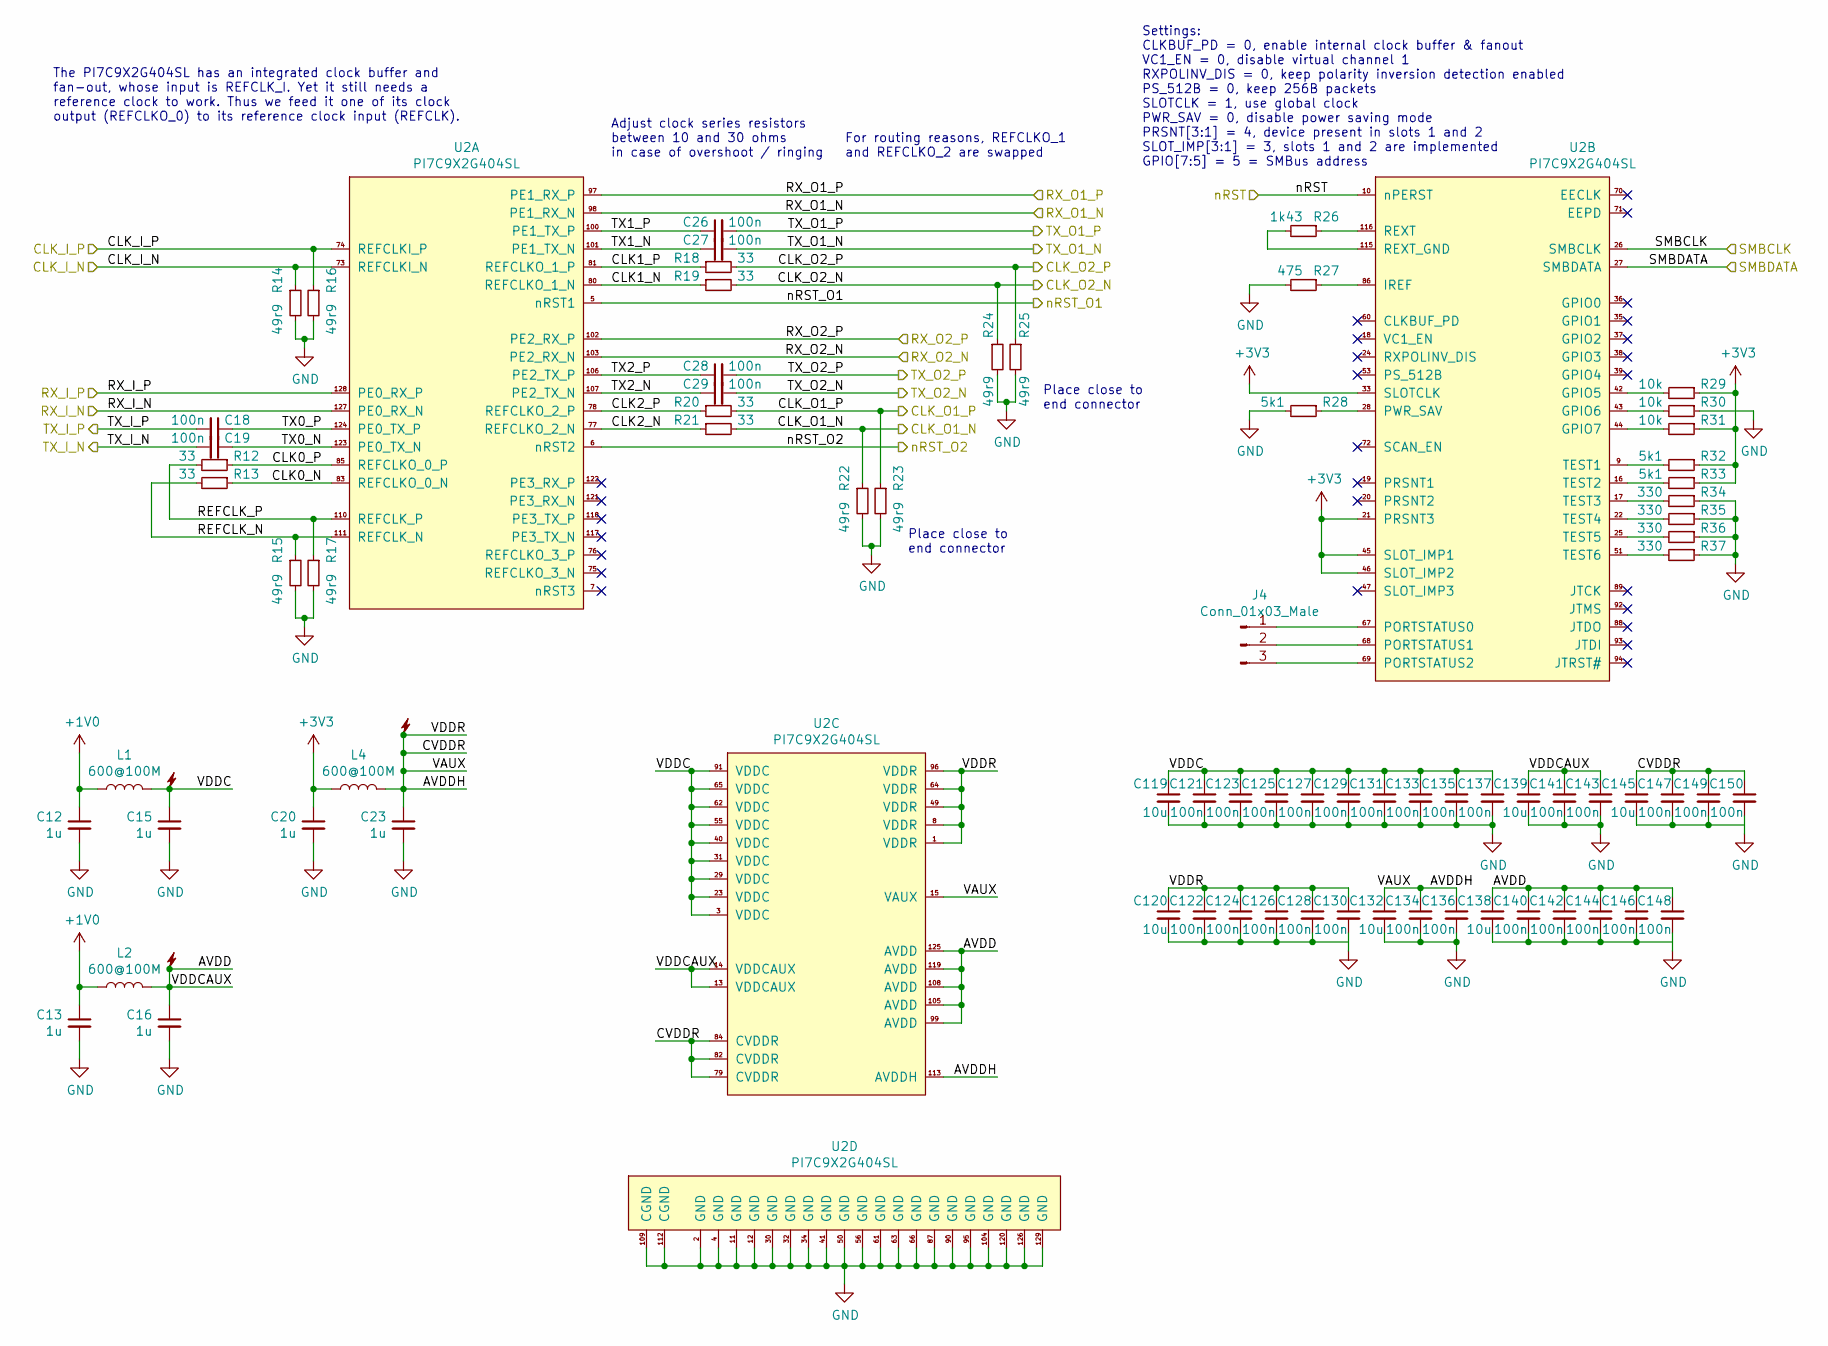
[picture p18: schematic pcie_switch.sch, PCIe Switch]

Parts:
C12, C13, C15, C16, C20, C23: 1u; C_0603_1608Metric
C18, C19, C26, C27, C28, C29: 100n; C_0402_1005Metric
C119, C120, C132, C138, C139, C145: 10u; C_0603_1608Metric
C121, C122, C123, C124, C125, C126, C127, C128, C129, C130, C131, C133, C134, C135, C136, C137, C140, C141, C142, C143, C144, C146, C147, C148, C149, C150: 100n; C_0603_1608Metric
J4: Conn_01x03_Male; PinHeader_1x03_P2.54mm_Vertical
L1, L2, L4: 600@100M; L_0603_1608Metric
R12, R13, R18, R19, R20, R21: 33; R_0402_1005Metric
R14, R15, R16, R17, R22, R23, R24, R25: 49r9; R_0402_1005Metric
R26: 1k43; R_0603_1608Metric
R27: 475; R_0603_1608Metric
R28, R32, R33: 5k1; R_0603_1608Metric
R29, R30, R31: 10k; R_0603_1608Metric
R34, R35, R36, R37: 330; R_0603_1608Metric
U2: PI7C9X2G404SL; LQFP-128_1EP_14x14mm_P0.4mm_EP6x6mm

Connections:
+1V0: C12.1, C13.1, L1.1, L2.1; also elsewhere on the board
/PCIE_X1_CLK_N: R14.1, U2.73 (REFCLKI_N); also elsewhere on the board
/PCIE_X1_CLK_P: R16.1, U2.74 (REFCLKI_P); also elsewhere on the board
/PCIE_X1_RX_N: C19.2; also elsewhere on the board
/PCIE_X1_RX_P: C18.2; also elsewhere on the board
/PCIE_X1_TX_N: U2.127 (PE0_RX_N); also elsewhere on the board
/PCIE_X1_TX_P: U2.128 (PE0_RX_P); also elsewhere on the board
/SMB_CLK: U2.26 (SMBCLK); also elsewhere on the board
/SMB_DATA: U2.27 (SMBDATA); also elsewhere on the board
/nRST: U2.10 (nPERST); also elsewhere on the board
/pcie/CLK_O1_N: R21.2, R22.1; also elsewhere on the board
/pcie/CLK_O1_P: R20.2, R23.1; also elsewhere on the board
/pcie/CLK_O2_N: R19.2, R24.1; also elsewhere on the board
/pcie/CLK_O2_P: R18.2, R25.1; also elsewhere on the board
/pcie/RX_O1_N: U2.98 (PE1_RX_N); also elsewhere on the board
/pcie/RX_O1_P: U2.97 (PE1_RX_P); also elsewhere on the board
/pcie/RX_O2_N: U2.103 (PE2_RX_N); also elsewhere on the board
/pcie/RX_O2_P: U2.102 (PE2_RX_P); also elsewhere on the board
/pcie/TX_O1_N: C27.2; also elsewhere on the board
/pcie/TX_O1_P: C26.2; also elsewhere on the board
/pcie/TX_O2_N: C29.2; also elsewhere on the board
/pcie/TX_O2_P: C28.2; also elsewhere on the board
/pcie/mpcie1/nRST: U2.5 (nRST1); also elsewhere on the board
/pcie/mpcie2/nRST: U2.6 (nRST2); also elsewhere on the board
/pcie/switch/CLK0_N: R13.1, U2.83 (REFCLKO_0_N)
/pcie/switch/CLK0_P: R12.1, U2.85 (REFCLKO_0_P)
/pcie/switch/CLK1_N: R19.1, U2.80 (REFCLKO_1_N)
/pcie/switch/CLK1_P: R18.1, U2.81 (REFCLKO_1_P)
/pcie/switch/CLK2_N: R21.1, U2.77 (REFCLKO_2_N)
/pcie/switch/CLK2_P: R20.1, U2.78 (REFCLKO_2_P)
/pcie/switch/REFCLK_N: R13.2, R15.1, U2.111 (REFCLK_N)
/pcie/switch/REFCLK_P: R12.2, R17.1, U2.110 (REFCLK_P)
/pcie/switch/TX0_N: C19.1, U2.123 (PE0_TX_N)
/pcie/switch/TX0_P: C18.1, U2.124 (PE0_TX_P)
/pcie/switch/TX1_N: C27.1, U2.101 (PE1_TX_N)
/pcie/switch/TX1_P: C26.1, U2.100 (PE1_TX_P)
/pcie/switch/TX2_N: C29.1, U2.107 (PE2_TX_N)
/pcie/switch/TX2_P: C28.1, U2.106 (PE2_TX_P)
unnamed: J4.1, U2.67 (PORTSTATUS0)
unnamed: J4.2, U2.68 (PORTSTATUS1)
unnamed: J4.3, U2.69 (PORTSTATUS2)
unnamed: R26.1, U2.116 (REXT)
unnamed: R26.2, U2.115 (REXT_GND)
unnamed: R27.1, U2.86 (IREF)
unnamed: R28.1, U2.28 (PWR_SAV)
unnamed: R29.2, U2.42 (GPIO5)
unnamed: R30.2, U2.43 (GPIO6)
unnamed: R31.2, U2.44 (GPIO7)
unnamed: R32.2, U2.9 (TEST1)
unnamed: R33.2, U2.16 (TEST2)
unnamed: R34.2, U2.17 (TEST3)
unnamed: R35.2, U2.22 (TEST4)
unnamed: R36.2, U2.25 (TEST5)
unnamed: R37.2, U2.51 (TEST6)

Notes on the sheet:
Settings: CLKBUF_PD = 0, enable internal clock buffer & fanout VC1_EN = 0, disable virtual channel 1 RXPOLINV_DIS = 0, keep polarity inversion detection enabled PS_512B = 0, keep 256B packets SLOTCLK = 1, use global clock PWR_SAV = 0, disable power saving mode PRSNT[3:1] = 4, device present in slot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
Place close to end connector
Adjust clock series resistors between 10 and 30 ohms in case of overshoot / ringing
The PI7C9X2G404SL has an integrated clock buffer and fan-out, whose input is REFCLK_I. Yet it still needs a reference clock to work. Thus we feed it one of its clock output (REFCLKO_0) to its reference clock input (REFCLK).
For routing reasons, REFCLKO_1 and REFCLKO_2 are swapped

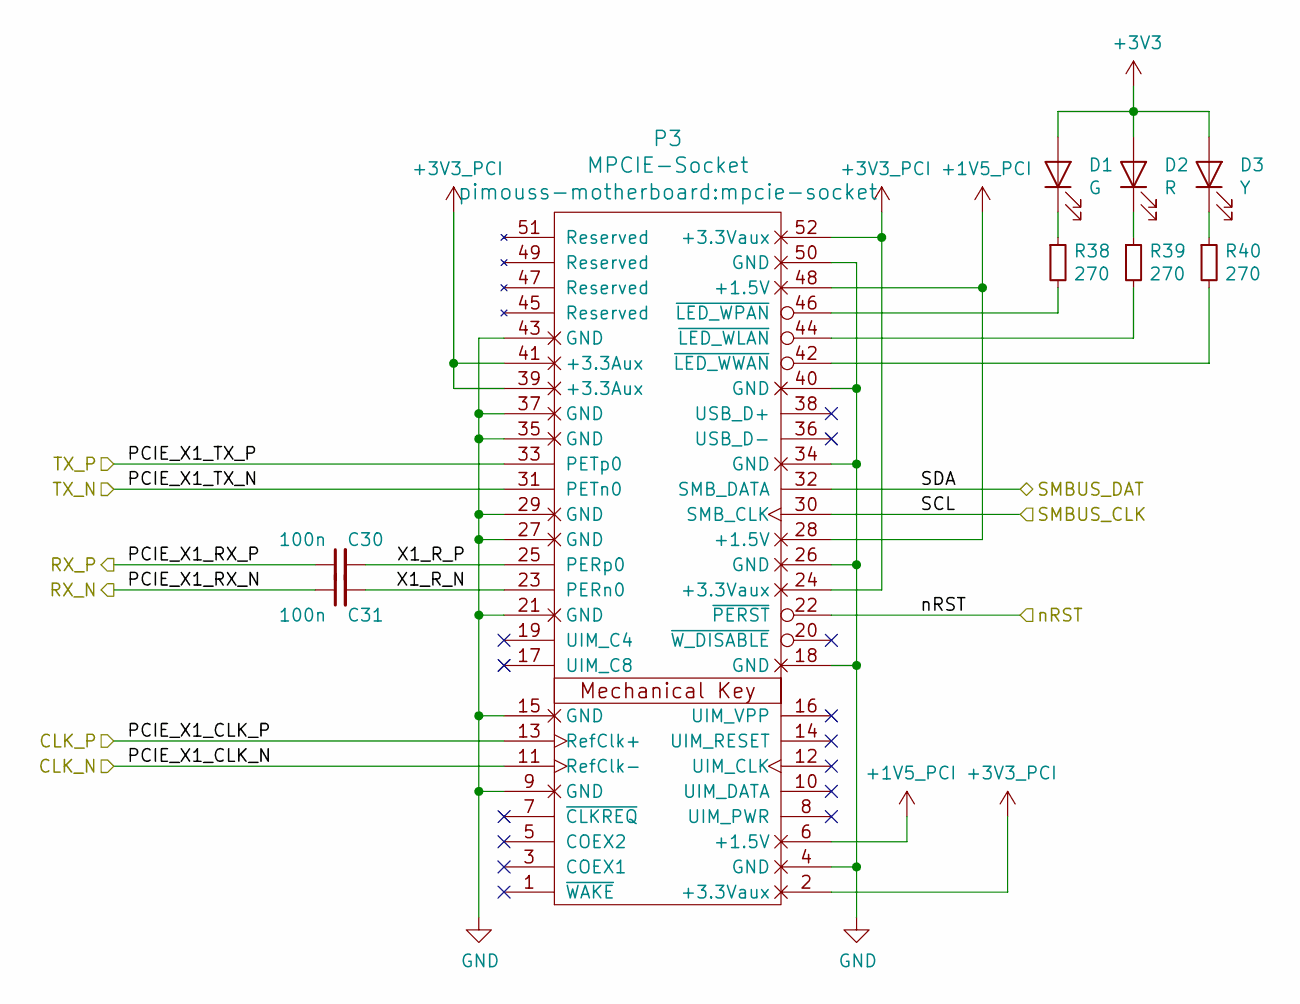
[picture p19: schematic pcie_mpcie.sch, Mini PCIe connector]

Parts:
C30, C31: 100n; C_0402_1005Metric
D1: G; D_0603_1608Metric
D2: R; D_0603_1608Metric
D3: Y; D_0603_1608Metric
P3: MPCIE-Socket; mpcie-socket
R38, R39, R40: 270; R_0603_1608Metric

Connections:
/SMB_CLK: P3.30 (SMB_CLK); also elsewhere on the board
/SMB_DATA: P3.32 (SMB_DATA); also elsewhere on the board
/pcie/CLK_O1_N: P3.11 (RefClk-); also elsewhere on the board
/pcie/CLK_O1_P: P3.13 (RefClk+); also elsewhere on the board
/pcie/RX_O1_N: C30.1; also elsewhere on the board
/pcie/RX_O1_P: C31.1; also elsewhere on the board
/pcie/TX_O1_N: P3.33 (PETp0); also elsewhere on the board
/pcie/TX_O1_P: P3.31 (PETn0); also elsewhere on the board
/pcie/mpcie1/X1_R_N: C31.2, P3.23 (PERn0)
/pcie/mpcie1/X1_R_P: C30.2, P3.25 (PERp0)
/pcie/mpcie1/nRST: P3.22 (~PERST); also elsewhere on the board
unnamed: D1.1 (K), R38.1
unnamed: D2.1 (K), R39.1
unnamed: D3.1 (K), R40.1
unnamed: P3.42 (~LED_WWAN), R40.2
unnamed: P3.44 (~LED_WLAN), R39.2
unnamed: P3.46 (~LED_WPAN), R38.2

Parts of its further copies:
C32, C33: 100n; C_0402_1005Metric
D4: G; D_0603_1608Metric
D5: R; D_0603_1608Metric
D6: Y; D_0603_1608Metric
P4: MPCIE-Socket; mpcie-socket
R41, R42, R43: 270; R_0603_1608Metric

Connections of its further copies:
/SMB_CLK: P4.30 (SMB_CLK); also elsewhere on the board
/SMB_DATA: P4.32 (SMB_DATA); also elsewhere on the board
/pcie/CLK_O2_N: P4.11 (RefClk-); also elsewhere on the board
/pcie/CLK_O2_P: P4.13 (RefClk+); also elsewhere on the board
/pcie/RX_O2_N: C32.1; also elsewhere on the board
/pcie/RX_O2_P: C33.1; also elsewhere on the board
/pcie/TX_O2_N: P4.33 (PETp0); also elsewhere on the board
/pcie/TX_O2_P: P4.31 (PETn0); also elsewhere on the board
/pcie/mpcie2/X1_R_N: C33.2, P4.23 (PERn0)
/pcie/mpcie2/X1_R_P: C32.2, P4.25 (PERp0)
/pcie/mpcie2/nRST: P4.22 (~PERST); also elsewhere on the board
unnamed: D4.1 (K), R41.1
unnamed: D5.1 (K), R42.1
unnamed: D6.1 (K), R43.1
unnamed: P4.42 (~LED_WWAN), R43.2
unnamed: P4.44 (~LED_WLAN), R42.2
unnamed: P4.46 (~LED_WPAN), R41.2

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
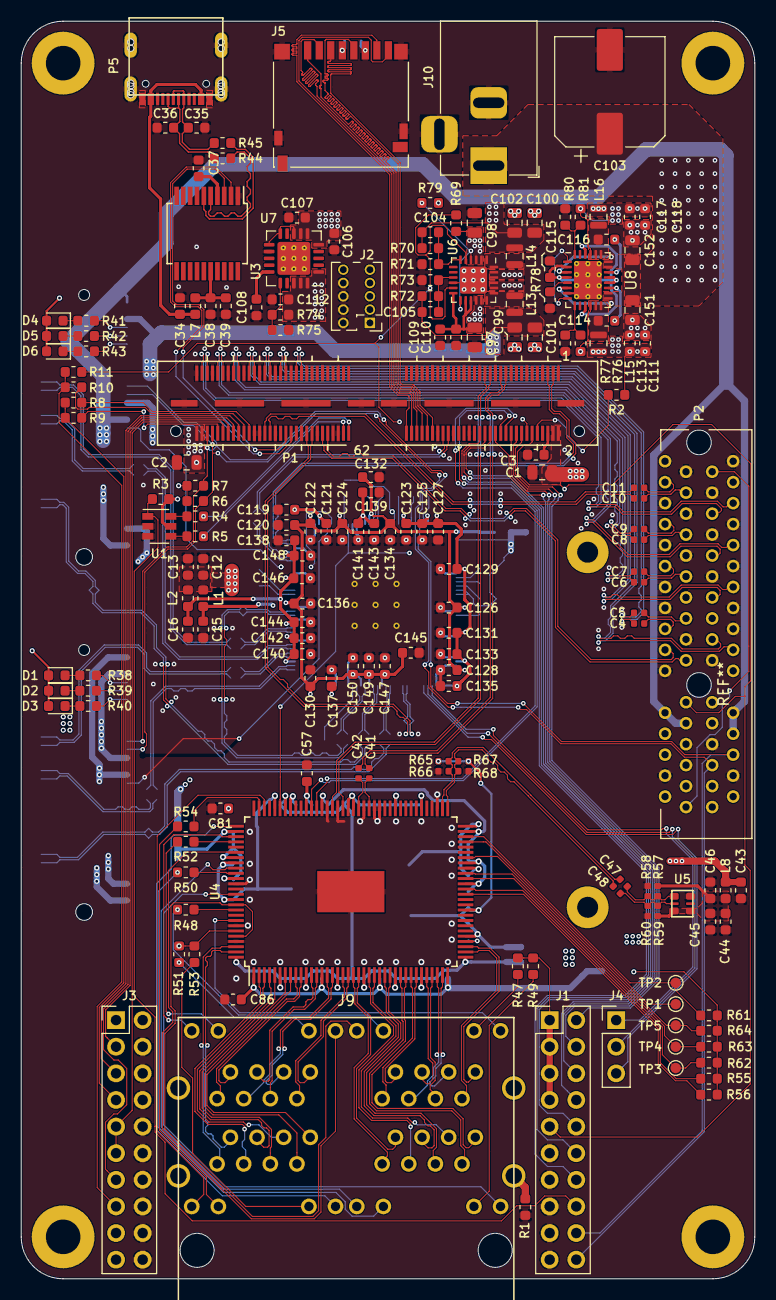
[picture p20: board pimouss-motherboard.kicad_pcb from above]

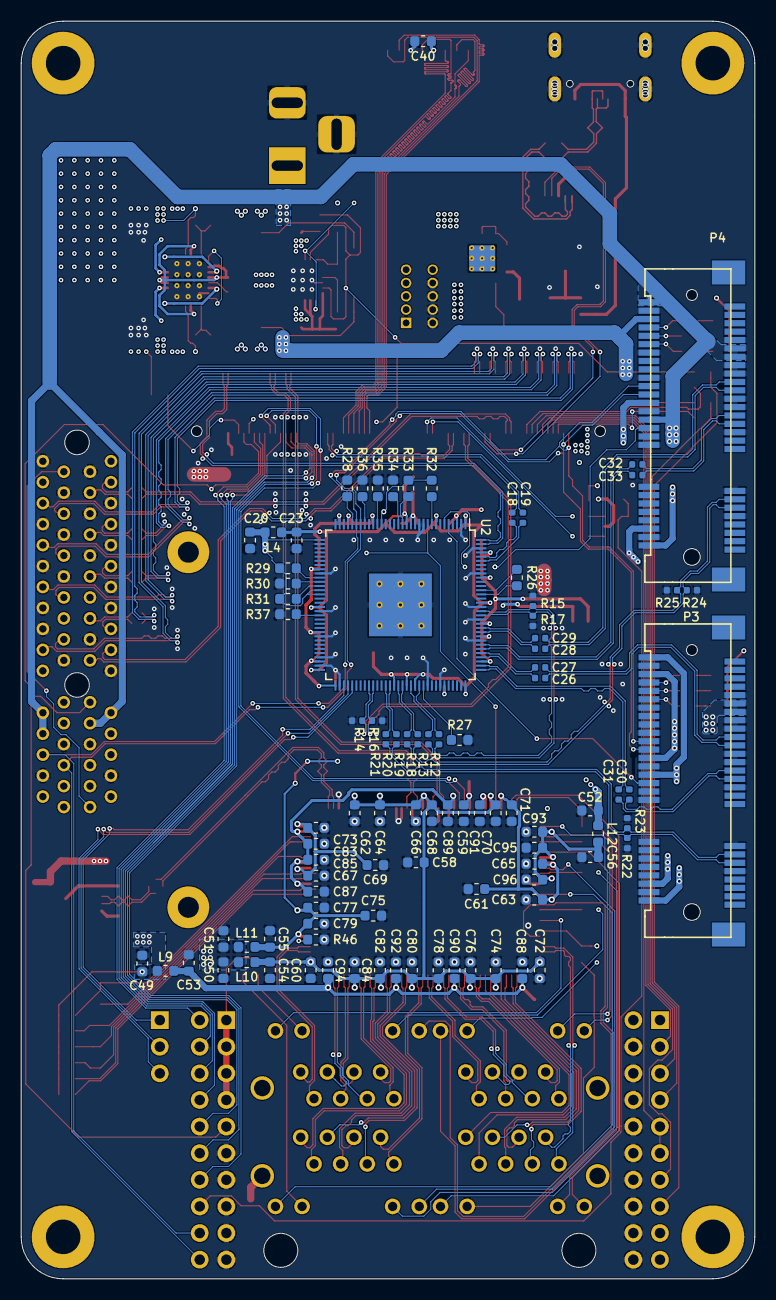
[picture p21: board pimouss-motherboard.kicad_pcb from below]

Board: 4 copper layers, 70.0 x 120.0 mm, 271 parts (93 on the bottom side), 241 nets.
