Tuetuopay/pimouss-motherboard/(commit log)

2019-03-20 lib: Add power rail symbols
    [phy.sch]
2019-03-20 lib: Fix some 88E1545 pin placements
2019-03-20 sch: Done PHY power supplies
    [phy_psu.sch]
2019-03-20 sch: Done phy data plane
    [phy_data.sch]
2019-03-20 sch: Done PHY control plane
    [phy_adm.sch]
2019-03-20 sch: USB-Serial console done
    [pimouss-motherboard.sch, usb-uart.sch]
2019-03-20 sch: Pimouss connector done
    [pimouss-motherboard.sch, pimouss.sch]
2019-03-20 sch: Plug PHY signals and misc cosmetic changes
    [pimouss-motherboard.sch]
2019-03-22 lib: Add X1 and X4 PCIe connectors
2019-03-23 sch: Add PCIe connectors
    [pcie.sch, pimouss-motherboard.sch, pimouss.sch]
2019-03-23 lib: Add 3D shape for PCIe x4 connector
2019-03-23 lib: Add 3D model for mini pcie socket
2019-03-23 sch: Add micro SD
    [micro-sd.sch, pcie.sch, phy.sch, phy_adm.sch, phy_data.sch, phy_psu.sch, pimouss-motherboard.sch, pimouss.sch]
2019-03-23 sch: Add PCIe power supply
    [pcie.sch, pimouss-motherboard.sch, power.sch]
2019-03-23 sch: Add 5V PSU
    [power.sch]
2019-03-23 sch: Add main power input
    [power.sch]
2019-03-23 lib: Add 89HPES4T4 PCIe switch
2019-03-23 lib: Add PI7C9X2G404SL PCIe switch
2019-03-23 sch: Misc fixes
    [micro-sd.sch, pcie.sch, phy.sch, phy_adm.sch, phy_data.sch, phy_psu.sch, pimouss-motherboard.sch, pimouss.sch]
2019-03-24 sch: Add second mPCIe port with PCIe switch
    [micro-sd.sch, pcie.sch, pcie_mpcie.sch, pcie_switch.sch, phy.sch, phy_adm.sch, phy_data.sch, phy_psu.sch]
2019-03-24 lib: Add TMS-105-57-G-D connector
    [TMS-105-57-G-D.stp]
2019-03-24 sch: Add some PCIe doc and termination resistors
    [pcie.sch, pcie_mpcie.sch, pcie_switch.sch]
2019-03-24 sch: Add pimouss power connector
    [pimouss.sch]
2019-03-24 sch: Swap mPCIe 1 and swtich sheets
    [pcie.sch, pcie_mpcie.sch, pcie_switch.sch]
2019-03-24 sch, lib: Upgrade to KiCAD 5.1.0
    [micro-sd.sch, pcie.sch, pcie_mpcie.sch, pcie_switch.sch, phy.sch, phy_adm.sch, phy_data.sch, phy_psu.sch]
2019-03-24 lib: Add close enough 3D model for USB C connector
    [USB-C-FEMALE.stp]
2019-03-24 sch: Add connectors for JTAG and GPIO
    [pimouss-motherboard.sch, pimouss.sch]
2019-03-25 sch: Renumber properly sheets
    [pcie.sch, pcie_mpcie.sch, pcie_switch.sch, phy.sch, phy_adm.sch, phy_data.sch, phy_psu.sch, pimouss-motherboard.sch]
2019-03-25 sch: Set DC input cap value
    [power.sch]
2019-03-25 sch, lib: Add 1V rail with TPS74401 LDO
    [power.sch]
2019-03-25 sch: Add misc doc texts
    [phy_adm.sch, phy_data.sch, pimouss.sch, usb-uart.sch]
2019-03-26 sch: Move PHY blocks to main page
    [micro-sd.sch, pcie.sch, pcie_mpcie.sch, pcie_switch.sch, phy.sch, phy_adm.sch, phy_data.sch, phy_psu.sch]
2019-03-26 sch: Better PCIe clock terminations
    [pcie_switch.sch, pimouss.sch]
2019-03-27 sch: Replace regular symbols with small variant
    Done for most capacitors and resistors
    [micro-sd.sch, pcie.sch, pcie_mpcie.sch, phy_adm.sch, phy_data.sch, pimouss.sch, power.sch, usb-uart.sch]
2019-03-29 sch: Misc fixes
    - add missing NC on PCIe switch
    - fix incorrect cap values on PCIe supply
    - fix main schematic interco labels
    - fix PHY JTAG signal name
    [pcie_switch.sch, phy_adm.sch, pimouss-motherboard.sch, power.sch]
2019-03-29 sch: Add PCIe switch clocks documentation
    [pcie_switch.sch]
2019-03-30 sch: Remove ALL busses since kicad's support is broken
    [micro-sd.sch, pcie.sch, phy_adm.sch, phy_data.sch, pimouss-motherboard.sch, pimouss.sch, usb-uart.sch]
2019-03-30 sch: Make ERC happy with dummy power outputs
    [pcie_switch.sch, phy_psu.sch, pimouss.sch, power.sch, usb-uart.sch]
2019-03-30 lib, sch: Misc changes to make ERC happy
    - add resistors to PCIe switch GPIOs
    - add NC flags on PHY unused LED outputs
    - add dummy supply on Earth PSU
    - add dummy supply on PHY ref clock's VCC
    - LTC3633: deduplicate SW1/2 outputs
    - ILS8033: deduplicate LX1/2 and PGND1/2 outputs
    [pcie_switch.sch, phy_adm.sch, phy_data.sch, pimouss-motherboard.sch, pimouss.sch, power.sch]
2019-03-30 lib: Move mPCIe socket to local lib
    [pcie_mpcie.sch]
2019-04-01 lib: Add footprint+3d for Vishay IHHP
    [L_Vishay_IHHP-0806.FCStd, L_Vishay_IHHP-0806.step]
2019-04-01 sch: Annotate & associate symbols with footprints
    [micro-sd.sch, pcie.sch, pcie_mpcie.sch, pcie_switch.sch, phy_adm.sch, phy_data.sch, phy_psu.sch, pimouss-motherboard.sch]
2019-04-02 sch: Fix PHY ref clk footprint
    [phy_adm.sch]
2019-04-02 lib, sch: Fix connectors refdes letter
    [micro-sd.sch, pcie.sch, pcie_mpcie.sch, pcie_switch.sch, phy_adm.sch, phy_data.sch, phy_psu.sch, power.sch]
2019-04-02 sch: Add missing differential net names
    [pcie_switch.sch]
2019-04-03 pro: Setup PCB stackup and DRC
2019-04-03 lib: Fix footprints texts sizes
2019-04-03 sch: Change PCIe series resistors to 33 ohm
    [pcie_switch.sch]
2019-04-04 sch: Add names to ALL PCIe nets
    [pcie.sch]
2019-04-08 sch: Change PHY decoupling caps from 100u to 100n
    [phy_psu.sch]
2019-04-10 sch: Fix typo in PCIe net names
    [pcie.sch]
2019-04-10 sch: Add missing decoupling caps for PCIe switch
    [pcie_switch.sch]
2019-04-12 lib: Fix PHY footprint
2019-04-12 pcb: PCIe SW and PHY decoupling caps done
    [pimouss-motherboard.kicad_pcb]
2019-04-22 pcb: PCIe buck mostly done
    [pimouss-motherboard.kicad_pcb]
2019-04-22 sch/power: Add main 5V buck input decoupling caps
    [power.sch]
2019-04-22 lib: Remove LTC3633 stupid bottom layer thermal pad
    [power.sch]
2019-04-22 pcb: Done main 12v->5v buck
    [pimouss-motherboard.kicad_pcb]
2019-04-22 lib: Add JSAE-5x8 RJ-45 connector footprint
2019-04-23 lib/RJSAE: Fix footprint pins for port B and D
2019-04-24 sch: Swap individual RJ45 with RJSAE connector
    [phy_data.sch]
2019-04-24 pcb: Group PSUs and (badly) route RJ45 connector
    [pimouss-motherboard.kicad_pcb]
2019-04-25 pcb: Put RJ jacks closer to PHY and wire PHY LEDs
    [pimouss-motherboard.kicad_pcb]
2019-04-25 pcb: Tune RJ45 diff lanes
    [pimouss-motherboard.kicad_pcb]
2019-04-27 pcb: Rework PCIe X4 connector fanout
    [pimouss-motherboard.kicad_pcb]
2019-04-27 pcb: Add PCIe switch power wiring
    [pimouss-motherboard.kicad_pcb]
2019-04-28 pcb: PHY PSU wiring done
    [pimouss-motherboard.kicad_pcb]
2019-04-30 lib: Add pimouss SoM symbol, footprint and 3D model
    The footprint is not a real one. It is mostly there to house the 3D
    model and placement holes positions
    [pimouss.FCStd]
2019-05-03 sch, master: Add pimouss SoM component
    [pimouss-motherboard.kicad_pcb, pimouss.sch]
2019-05-04 sch: Simplify PSU
    [pcie_switch.sch, power.sch]
2019-05-04 Add several 3D models w/ footprints
    - Barrel Jack 3D model
    - Mini PCIe card
    - PCIe 4X card
    [barrel_jack.FCStd, barrel_jack.step, mpcie_card.FCStd, mpcie_card.step, pcie_4x.FCStd, pcie_4x.step]
2019-05-04 lib: Fix RJ45 block holes
2019-05-04 lib: Fix mini-pcie footprint
    remove dumb silkscreen squares along it...
2019-05-04 lib: Add simple plated hole footprint
    used as mounting hole
2019-05-04 pcb: Place all components on the board
    only routing left...
    [pimouss-motherboard.kicad_pcb]
2019-05-05 sch: Swap some PCIe switch pairs for routing reasons
    - Swap clock outputs
    - Swap data polarities
    [pcie.sch, pcie_switch.sch]
2019-05-05 pcb: Routed PCIe differential tracks
    [pimouss-motherboard.kicad_pcb]
2019-05-10 pcb: ROUTE ALL THE THINGS
    [pimouss-motherboard.kicad_pcb]
2019-06-01 pcb: Redo all PCIe tracks with smaller tracks and larger clearance
2019-06-01 *: Fix CH430C footprint
    [usb-uart.sch]
2019-06-01 *: Fix TPS74401 thermal pad on bottom layer
    [power.sch]
2019-06-09 pcb: Minor fixes
2019-06-10 pcb: Rewire some PCIe pairs and add more clearances
2019-06-12 pcb: Better clearances
2019-06-12 pcb: Rewire some PCIe for better clearances
2019-06-13 pcb: Get rid of most antennas
2019-06-13 pcb: Stitch ground and cosmetic additions
2019-06-18 lib: Finally fix TSM-105 symbol
    [pimouss.sch]
2019-06-18 pcb: Add more 12V caps
    [power.sch]
2019-06-19 pcb: Re-tune PCIe pairs
    Place tuning wiggles closer to bends for better integrity
2019-06-19 pcb: Add diff pair skew tuning parameters
2019-06-19 pcb: Fix a via and add OSHW logo
2019-06-19 pcb: Add OSHW logo and some silkscreen
2019-06-19 pcb: Add Rev 1.0 silk
2019-06-25 pcb: Misc PCIe connector stuff
2019-06-26 sch, pcb: Add testpads on lots of signals
    [pcie.sch, pcie_switch.sch, phy_adm.sch, phy_psu.sch, pimouss.sch, power.sch, usb-uart.sch]
2019-06-27 lib, sch, pcb: Use larger footprint for DCS1122
    The 3.2x2.5mm chip is WAY easier to source than the 2.5x2
    [phy_adm.sch]
2019-06-27 pcb: Misc fixes
2019-06-29 lib, sch: Better solder paste layer for the QFP chips
2019-08-25 pro: Fix solder mask minimum width
    Previous wasn't small enough, not putting any between 0.4mm QFPs,
    rendering hand soldering terrible
2019-10-10 sch, pcb: Connect ISL8033 PGND to GND, fix UART
    Pimouss won't boot when its TXD line is pulled up, which the CH340 does.
    [power.sch, usb-uart.sch]
2019-10-10 *: Fix MDIO and MDC being swapped
    [pimouss-motherboard.sch]
2019-10-11 *: Fix TPS74401 BIAS supply voltage
    Somewhere hidden in the datasheed, it is mentioned that
    Vbias >= Vout + 1.62V... Only in two places, and not clearly stated.
    [power.sch]
2019-11-06 pcb: Change MDIO vias (dunno what changed, ask KiCAD)
2019-11-06 sch: Replace CH340C with FT230XS
    CH340 pulls up its RXD line, which makes the pimouss unhappy: nothing
    will get out of the UART port when its TXD line is held high on boot
    [power.sch, usb-uart.sch]
2019-11-06 fp: Fix fu*** QSH-060-01 footprint
    - Pins were the wrong length
    - Pins were the wrong distance from the center
    - Ground pads were the wrong length
    - Ground pads were the wrong distance and spacing
    - Mounting holes had the wrong spacing
2019-11-07 sch: Remove BSTRAP_H/L test pads
    [pimouss.sch]
2019-11-07 pcb: Update QSH footprint and reroute nearby traces
2019-11-19 sch, pcb: Replace CH340 with FT230 and add USB host port
    [pimouss.sch, usb-uart.sch]
2019-11-19 sch: Changed PCIe switch debug header to test pads
    [pcie_switch.sch]
2019-11-19 pcb: Change mounting holes and widen debug headers
    - Change mounting holes from 3.3mm to 3.1mm
    - Move mounting holes closer to board outline
    - Move debug headers (CPU JTAG and GPIOs) further away from quad RJ45
2019-11-19 pcb: Move pimouss power connector a bit right
2019-11-19 pcb: Move some test points out of under the pimouss
2019-11-20 pcb: Move OSHW logo to a more visible place
2019-11-23 fp: Add missing corner holes footprint
2019-11-23 fp: Add KUSBX-SL-CS1N14-B USB-C connector
    [KUSBX-SL-CS1N14-B.FCStd, KUSBX-SL-CS1N14-B.step]
2019-11-23 sch, pcb: Replace USB-C connectors with vertical ones
    [pimouss.sch, usb-uart.sch]
2019-11-25 sch, pcb: Replace large JTAG headers with 1.27 ones
    [pcie_switch.sch, phy_adm.sch, pimouss.sch]
2019-12-03 Add kicad bak files to gitignore
